emilyahmad/supercon-26/firmware/README.md

# Billboard Badge Firmware

# Micropython
Baseline micropython 1.27
Download from https://micropython.org/download/ESP32_GENERIC_S3/ `Firmware (Support for Octal-SPIRAM)` v1.27.0 .bin
`esptool.py --baud 460800 write_flash 0 ~/Downloads/ESP32_GENERIC_S3-SPIRAM_OCT-20251209-v1.27.0.bin`

# Build notes (lvgl_micropython) (Deprecated)
You need to sync the lvgl_micropython submodule and it's recursive submoules.
Then in `firmware/lvgl_micropython/lib/lv_conf.h`, find `#define LV_USE_LODEPNG 1` and change it to `0`.

lvgl_micropython build command from `firmware/lvgl_micropython`: `GEN_SCRIPT=python python make.py esp32s3 --custom-board-path=../lvgl_billboard_badge/`
Requires `toml` python package be installed.

Building outputs a command to flash: `~/.espressif/python_env/idf5.5_py3.14_env/bin/python -m esptool --chip esp32s3 -p /dev/ttyACM0 -b 460800 --before default_reset --after hard_reset write_flash --flash_mode dio --flash_size 16MB --flash_freq 80m --erase-all 0x0 ./build/lvgl_micropy_lvgl_billboard_badge.bin`

# Build notes (lv_micropython)

Install esp-idf: https://github.com/lvgl/lv_micropython/blob/master/ports/esp32/README.md#setting-up-the-toolchain-and-esp-idf
`./install.sh` and `. ./export.sh` in the shell that will be doing builds.

In `firmware/lv_micropython/ports/esp32` run `make BOARD=ESP32_GENERIC_S3 BOARD_VARIANT=BILLBOARD_BADGE`  to build and `python -m esptool --chip esp32s3 -b 460800 --before default_reset --after hard_reset write_flash --flash_mode dio --flash_size 16MB --flash_freq 80m 0x0 build-ESP32_GENERIC_S3-BILLBOARD_BADGE/bootloader/bootloader.bin 0x8000 build-ESP32_GENERIC_S3-BILLBOARD_BADGE/partition_table/partition-table.bin 0x10000 build-ESP32_GENERIC_S3-BILLBOARD_BADGE/micropython.bin` to flash.
You will need to `make clean BOARD=ESP32_GENERIC_S3 BOARD_VARIANT=BILLBOARD_BADGE` (yes including the arguments) to rebuild. The BOARD argument defines a build directory, so clean won't clean the correct directory without it.

Flashing the pre-built bin files: From `firmware/` run `python -m esptool --chip esp32s3 -b 460800 --before default_reset --after hard_reset write_flash --flash_mode dio --flash_size 8MB --flash_freq 80m 0x0 bin/bootloader.bin 0x8000 bin/partition-table.bin 0x10000 bin/micropython.bin`. To get into the mode to flash this, you need to hold down the BOOT button while either plugging in or pressing and releasing RESET.

## lv_micropython changes:
Copy the files from `firmware/lv_files/` to their matching paths, ex: `lv_files/foo/` -> `lv_micropython/foo/`.
