emilyahmad/supercon-26/assets/gallery/2026recap-dithered.png

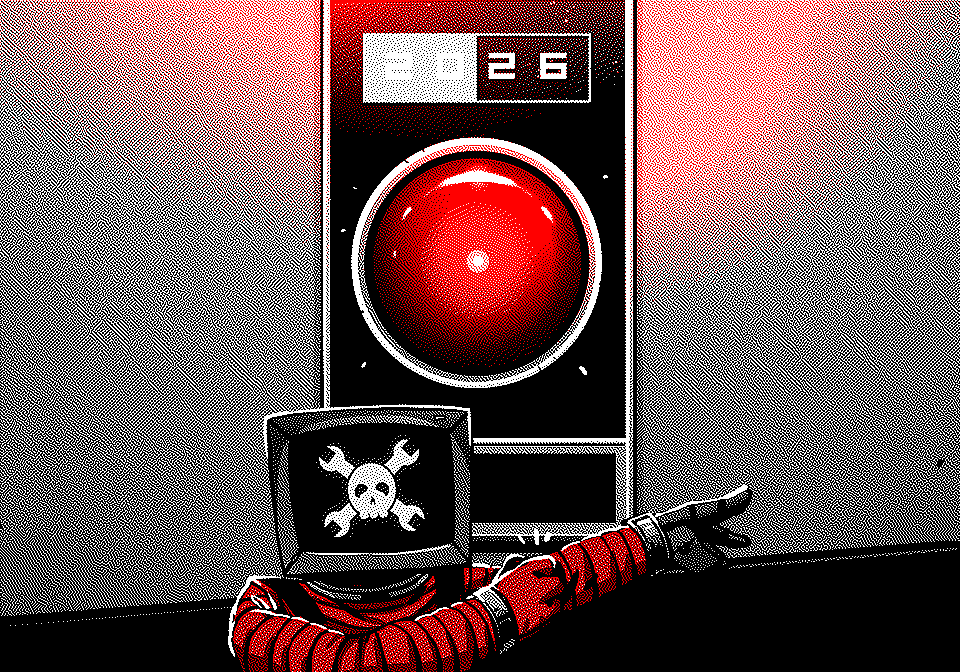
assets/gallery/2026recap-dithered.png
