emilyahmad/supercon-26/assets/gallery/Accelerometers-dithered.png

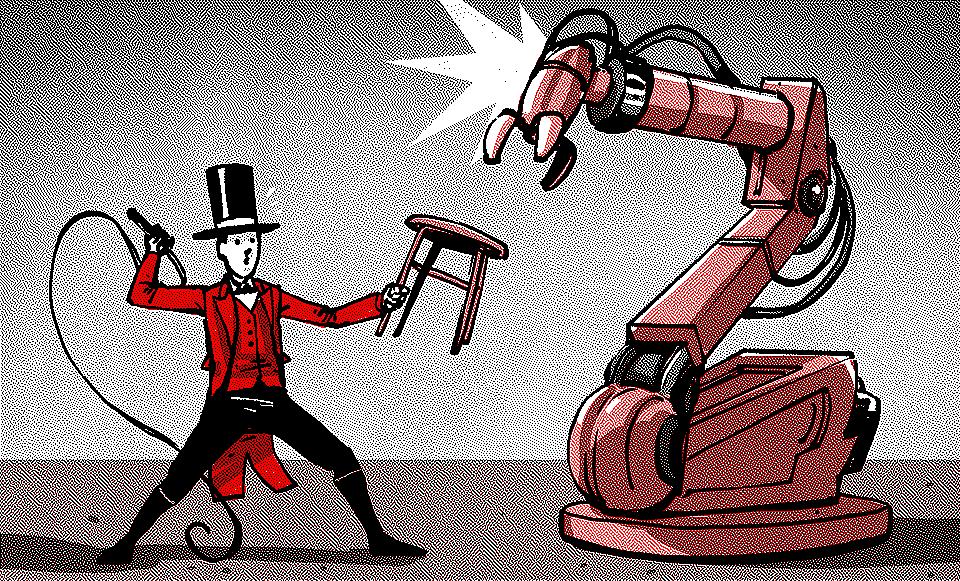
assets/gallery/Accelerometers-dithered.png
