emilyahmad/supercon-26/assets/gallery/AmateurRadio-dithered_dizzy_bw.png

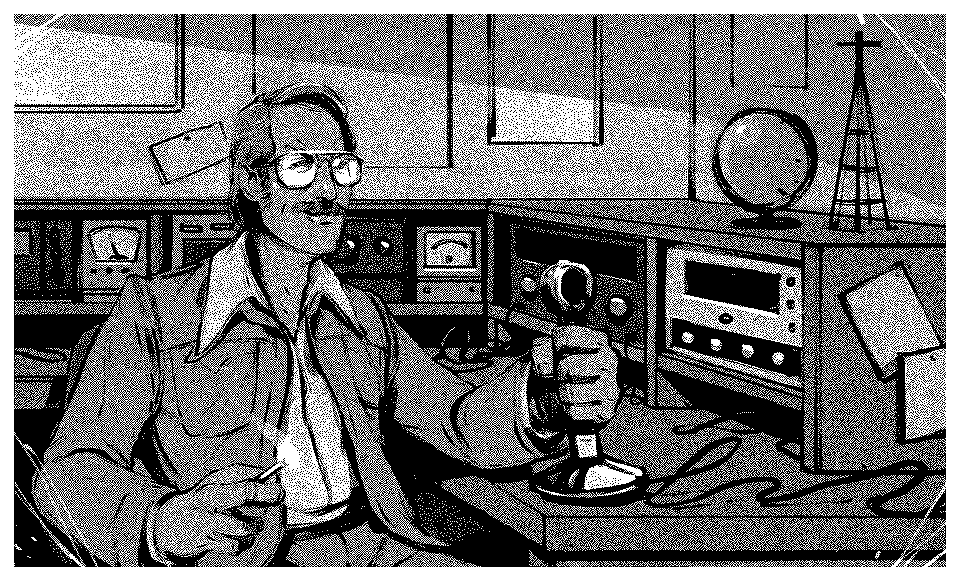
assets/gallery/AmateurRadio-dithered_dizzy_bw.png
