emilyahmad/supercon-26/assets/gallery/COBOL-dithered.png

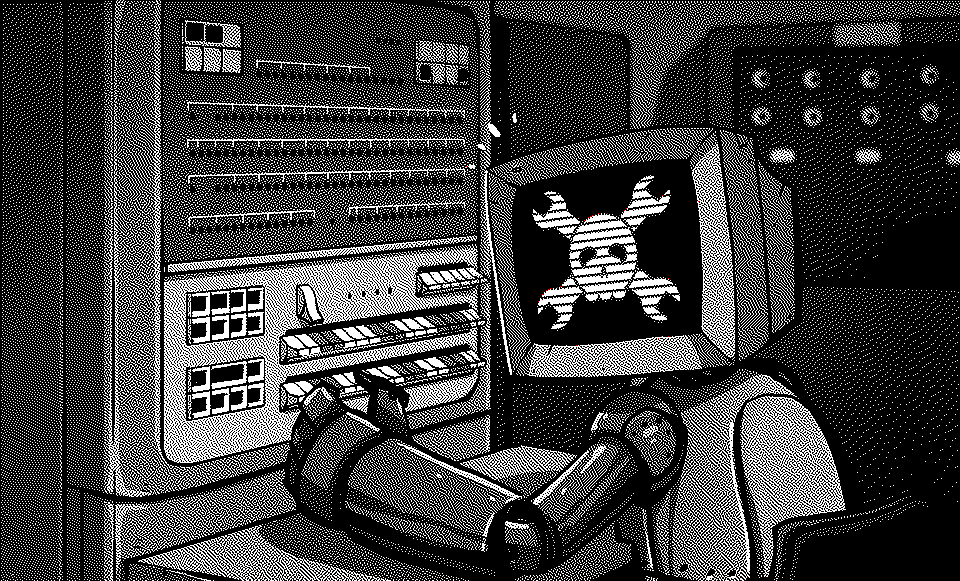
assets/gallery/COBOL-dithered.png
