emilyahmad/supercon-26/assets/gallery/Glass-dithered.png

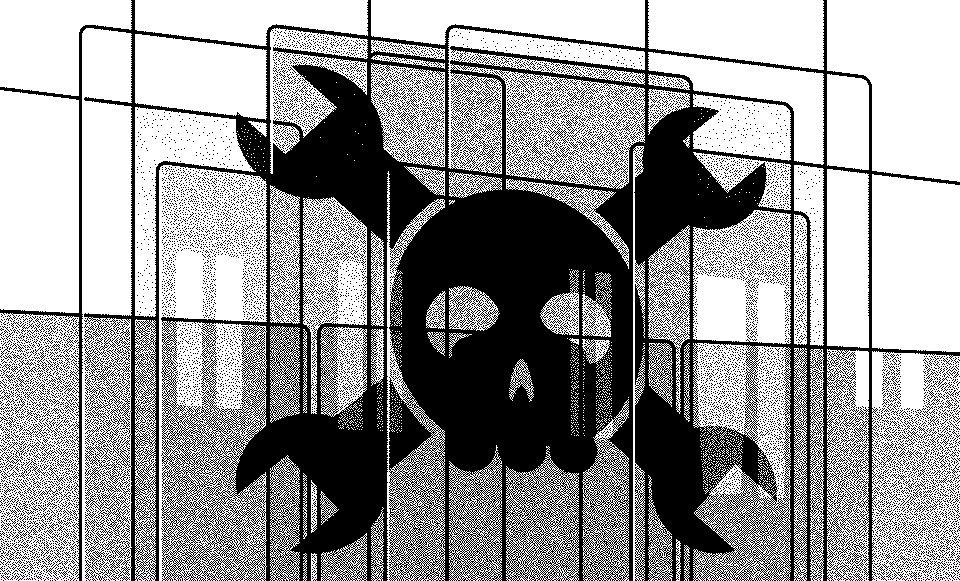
assets/gallery/Glass-dithered.png
