emilyahmad/supercon-26/assets/gallery/Hackaday20-dithered.png

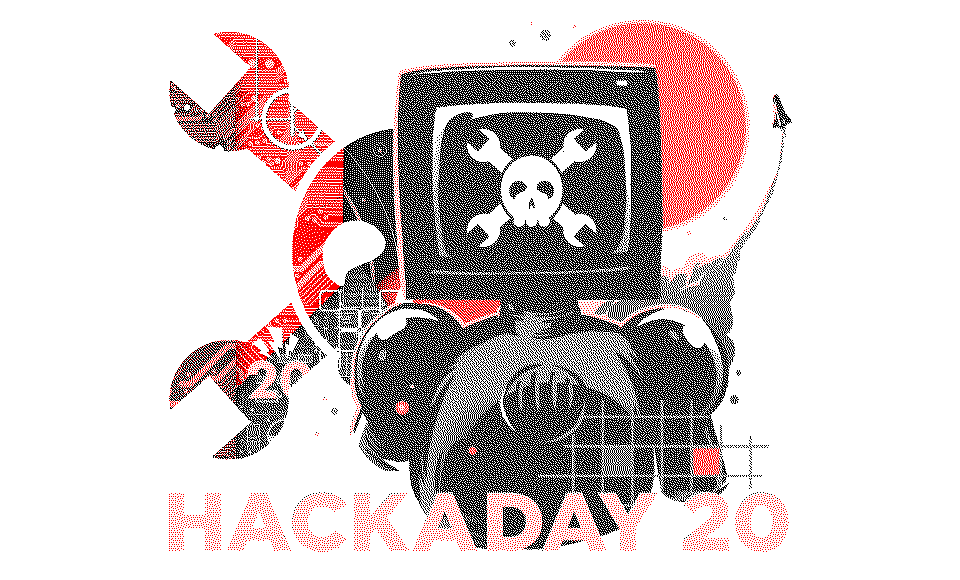
assets/gallery/Hackaday20-dithered.png
