emilyahmad/supercon-26/assets/gallery/had_01_black.jpg

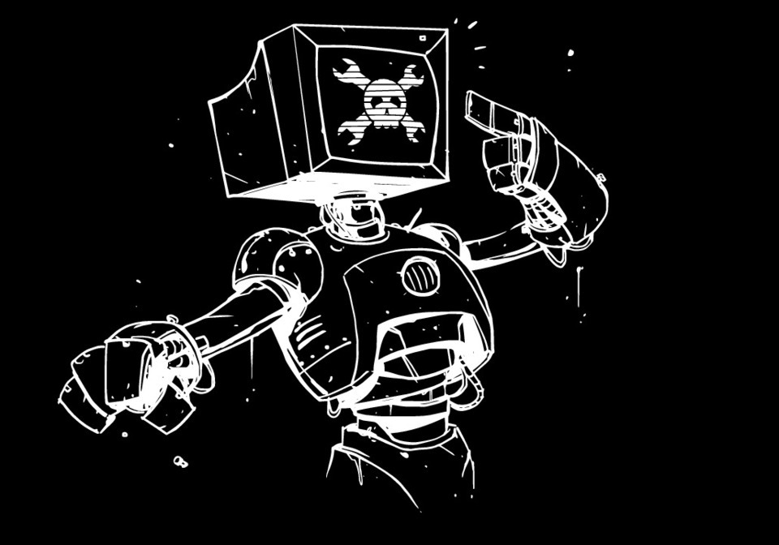
assets/gallery/had_01_black.jpg
