emilyahmad/supercon-26/assets/gallery/HomeElectrical-dithered.png

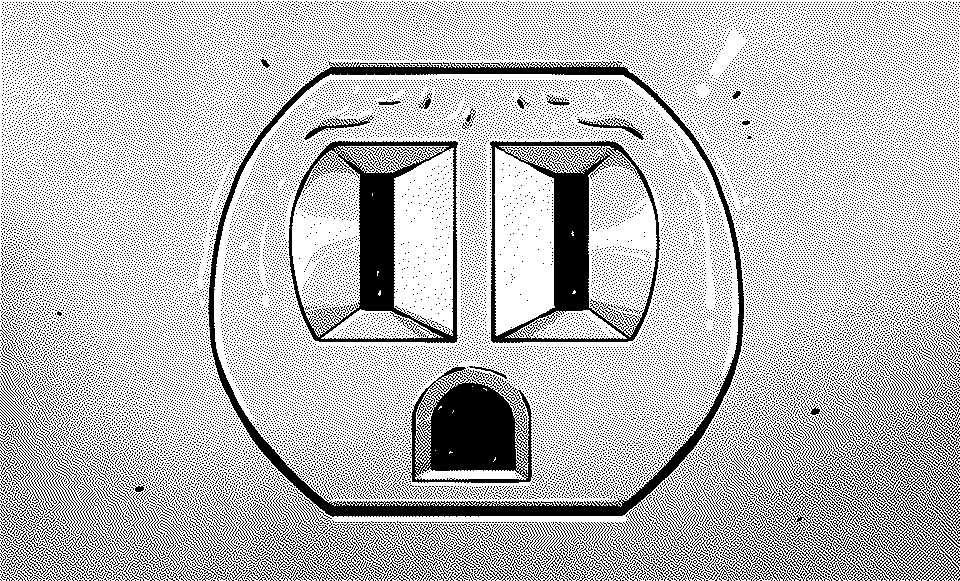
assets/gallery/HomeElectrical-dithered.png
