emilyahmad/supercon-26/assets/gallery/IntelManagment-dithered.png

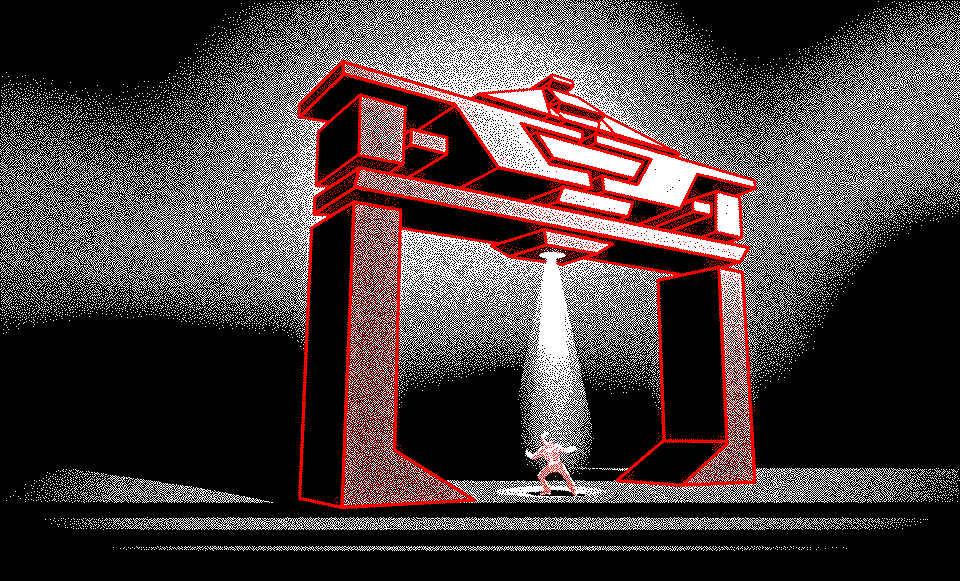
assets/gallery/IntelManagment-dithered.png
