emilyahmad/supercon-26/assets/gallery/LED-dithered.png

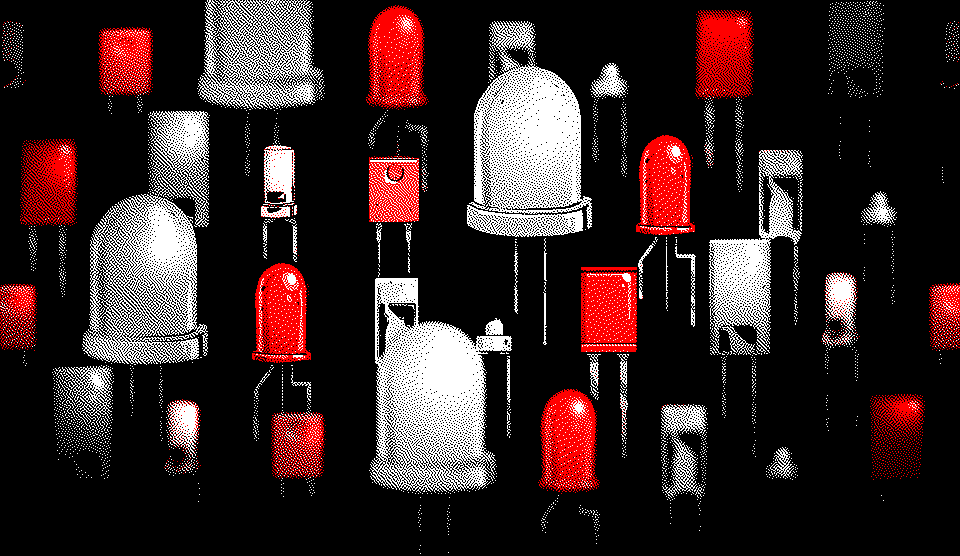
assets/gallery/LED-dithered.png
