emilyahmad/supercon-26/assets/gallery/LEDsensor-dithered.png

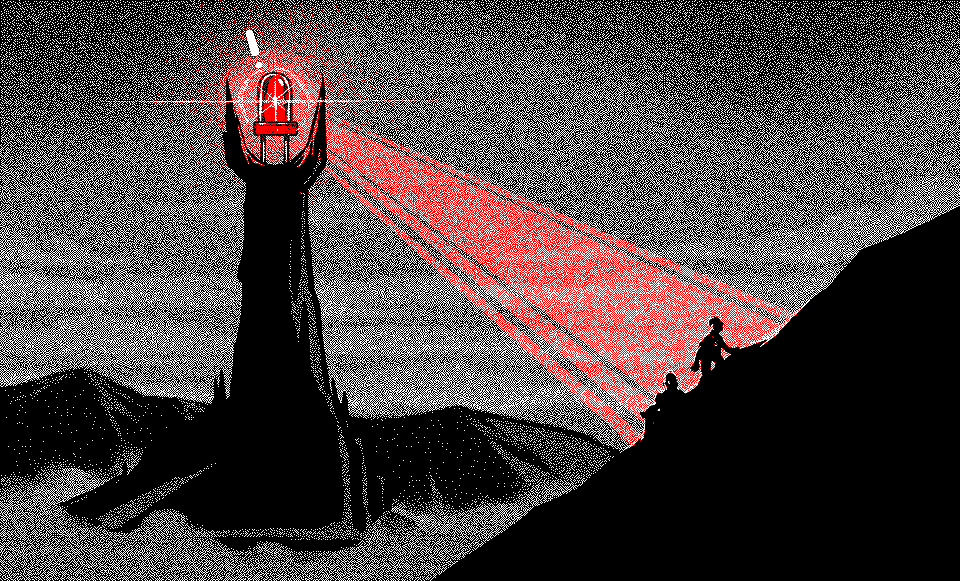
assets/gallery/LEDsensor-dithered.png
