emilyahmad/supercon-26/assets/gallery/London-dithered.png

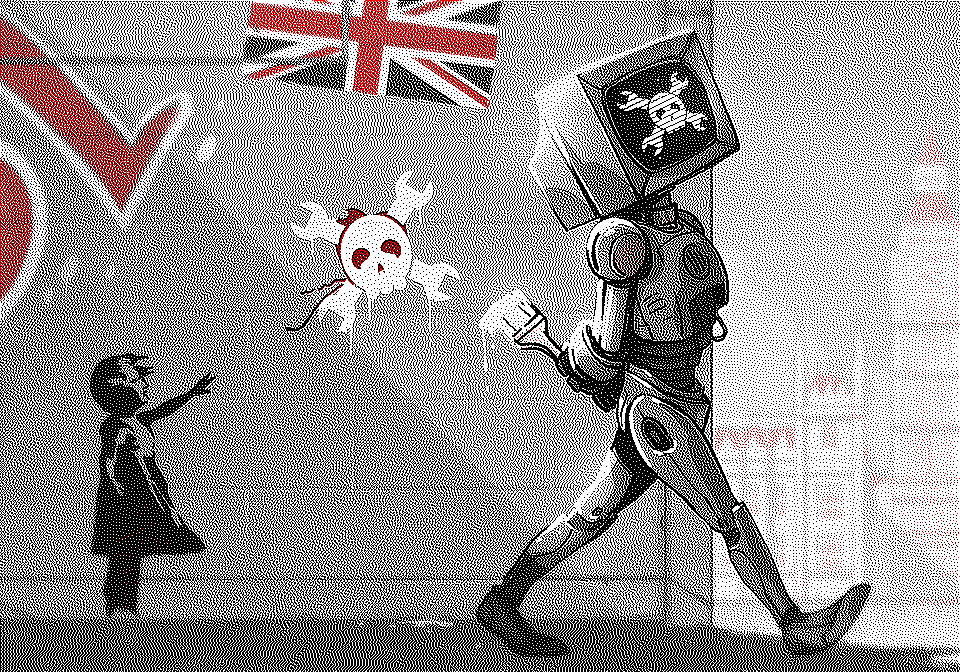
assets/gallery/London-dithered.png
