emilyahmad/supercon-26/assets/gallery/Mars-dithered.png

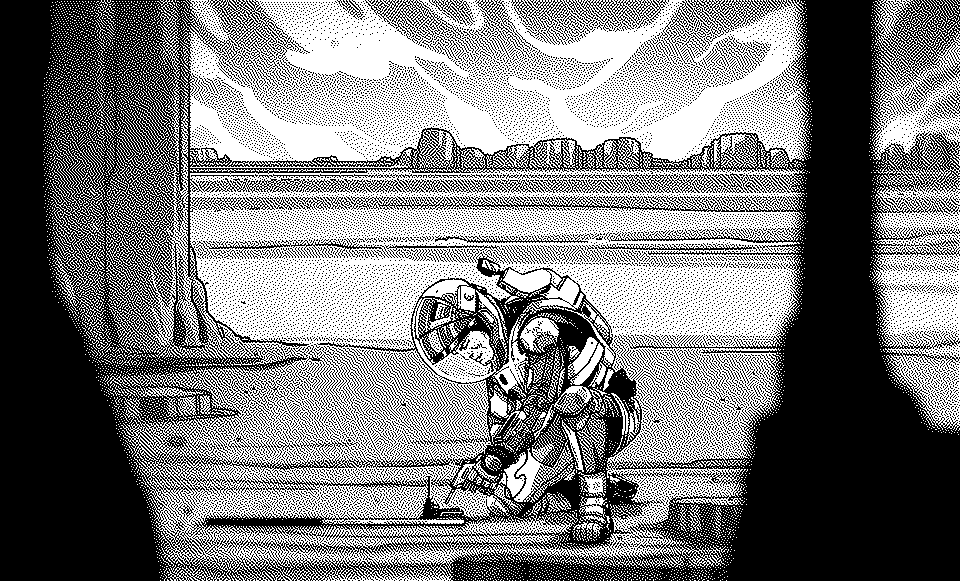
assets/gallery/Mars-dithered.png
