emilyahmad/supercon-26/assets/gallery/Memories-dithered.png

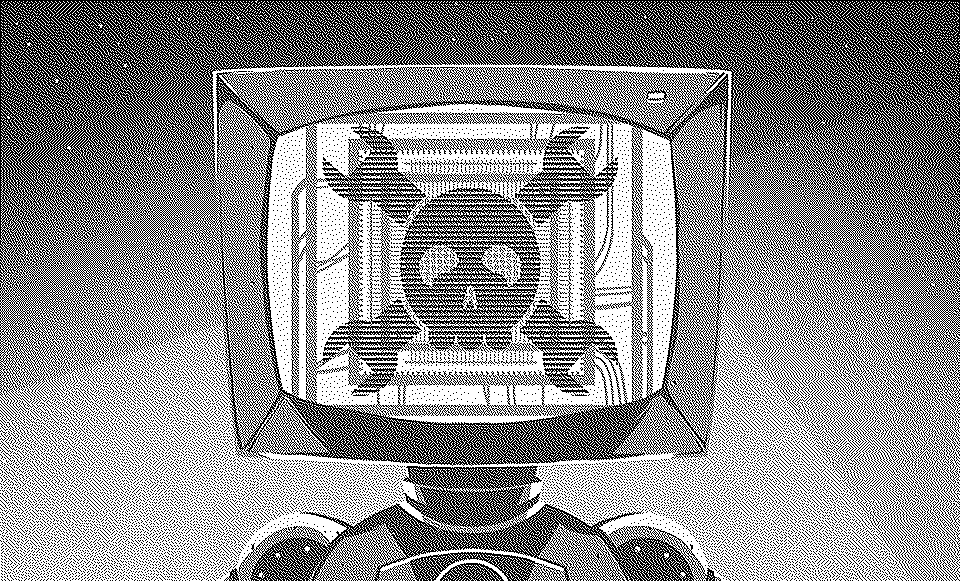
assets/gallery/Memories-dithered.png
