emilyahmad/supercon-26/assets/gallery/MisuingDIP-dithered.png

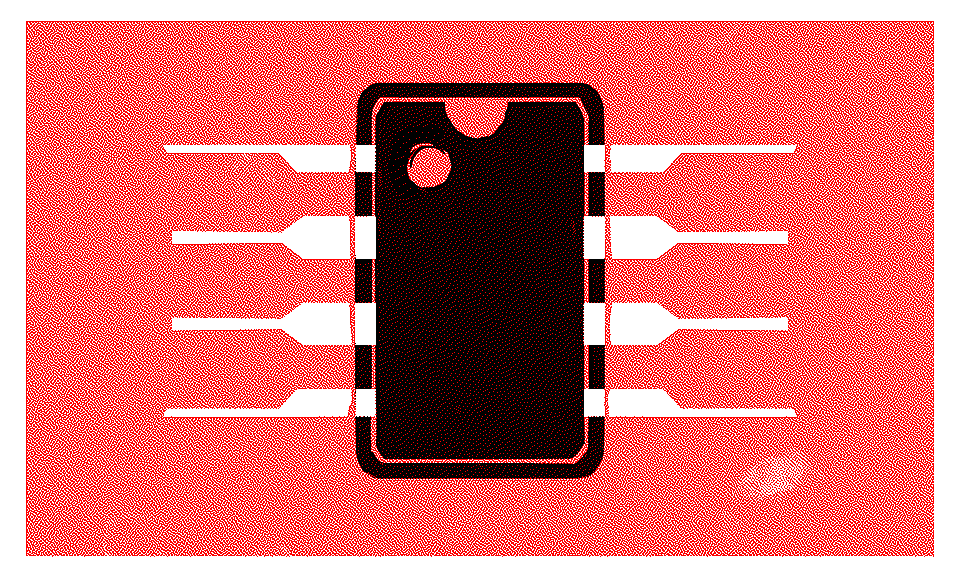
assets/gallery/MisuingDIP-dithered.png
