emilyahmad/supercon-26/assets/gallery/PCBdesign-dithered-shiaufan2.png

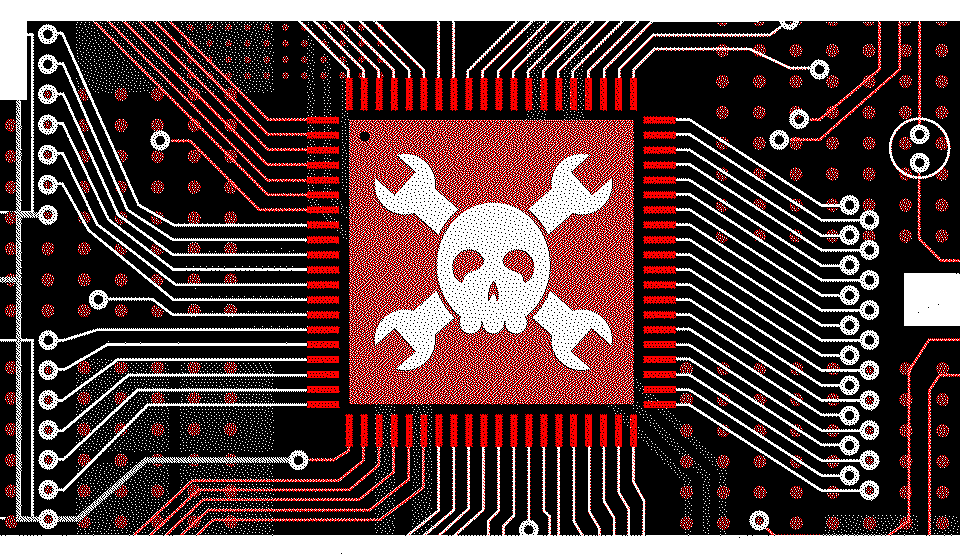
assets/gallery/PCBdesign-dithered-shiaufan2.png
