emilyahmad/supercon-26/assets/gallery/Pioneer-dithered.png

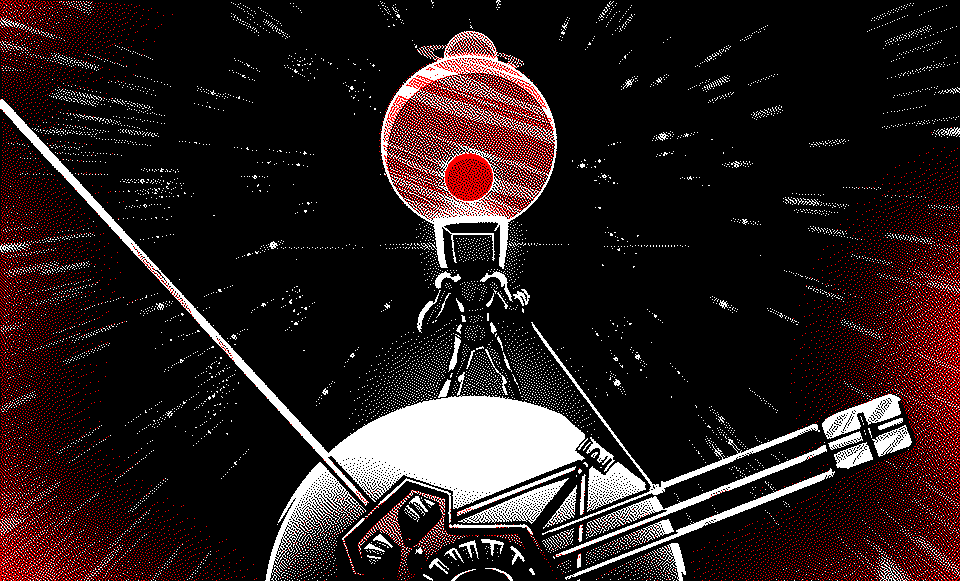
assets/gallery/Pioneer-dithered.png
