emilyahmad/supercon-26/assets/gallery/Potentiometer-dithered.png

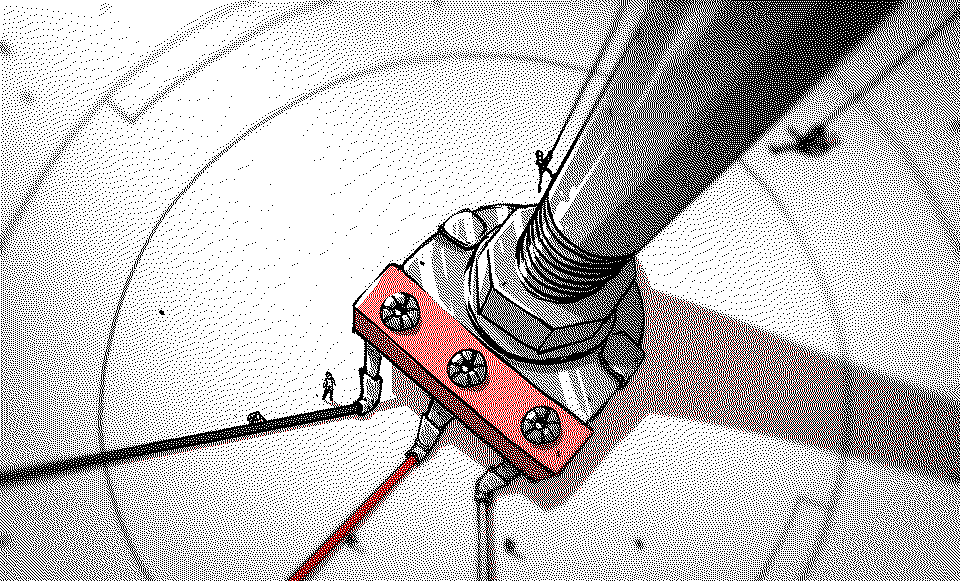
assets/gallery/Potentiometer-dithered.png
