emilyahmad/supercon-26/assets/gallery/RockerBogie-dithered.png

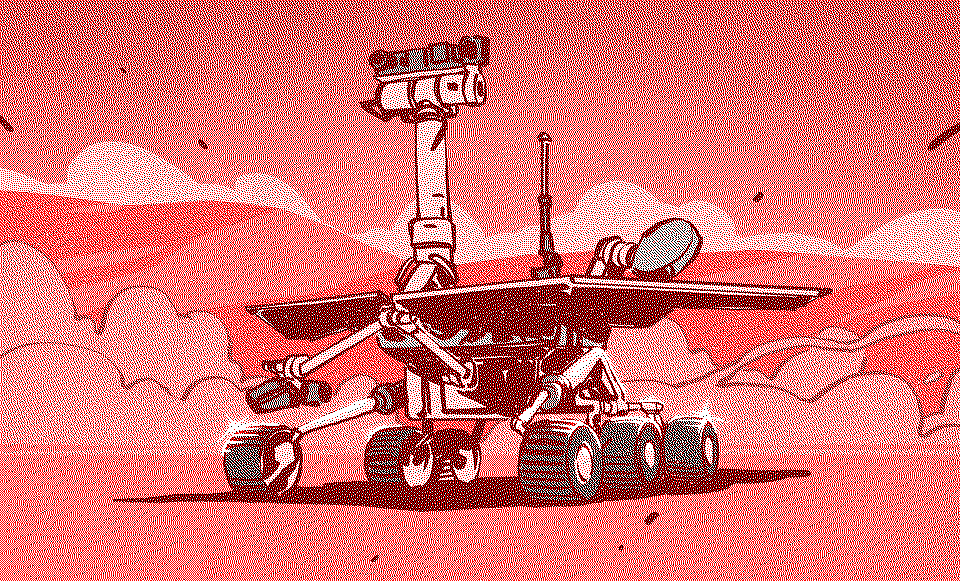
assets/gallery/RockerBogie-dithered.png
