emilyahmad/supercon-26/assets/gallery/RPN-dithered_atkinson.png

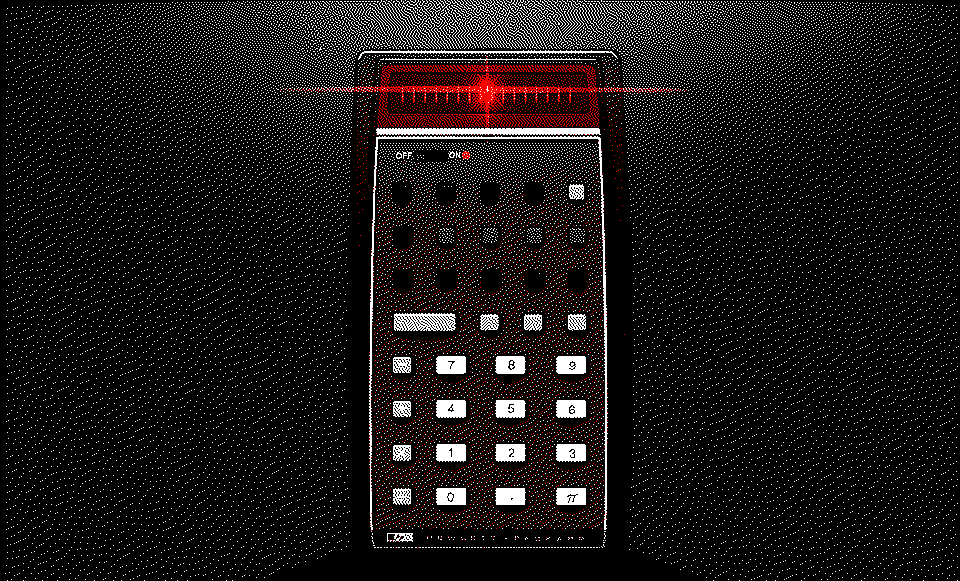
assets/gallery/RPN-dithered_atkinson.png
