emilyahmad/supercon-26/assets/gallery/Scrappy-dithered.png

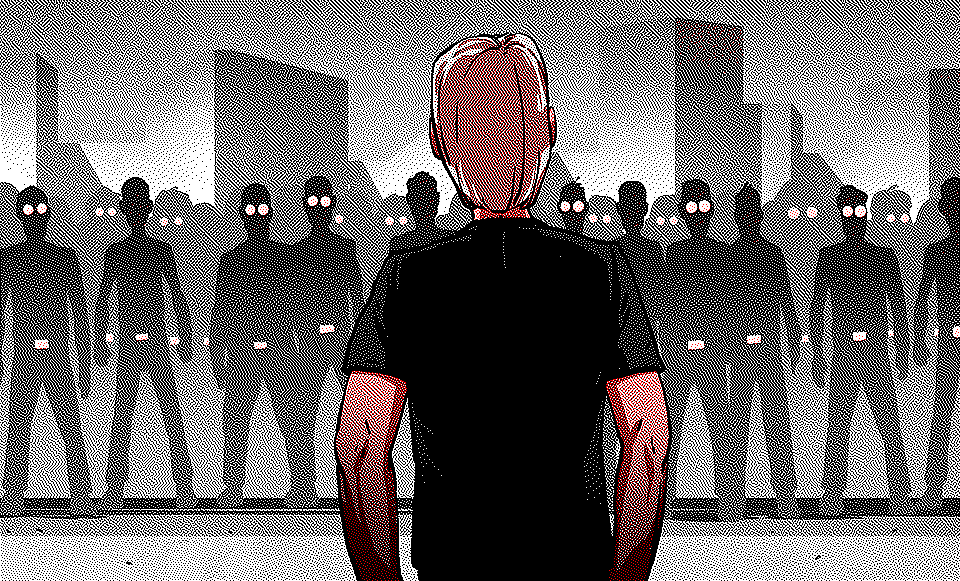
assets/gallery/Scrappy-dithered.png
