emilyahmad/supercon-26/assets/gallery/Screw-dithered.png

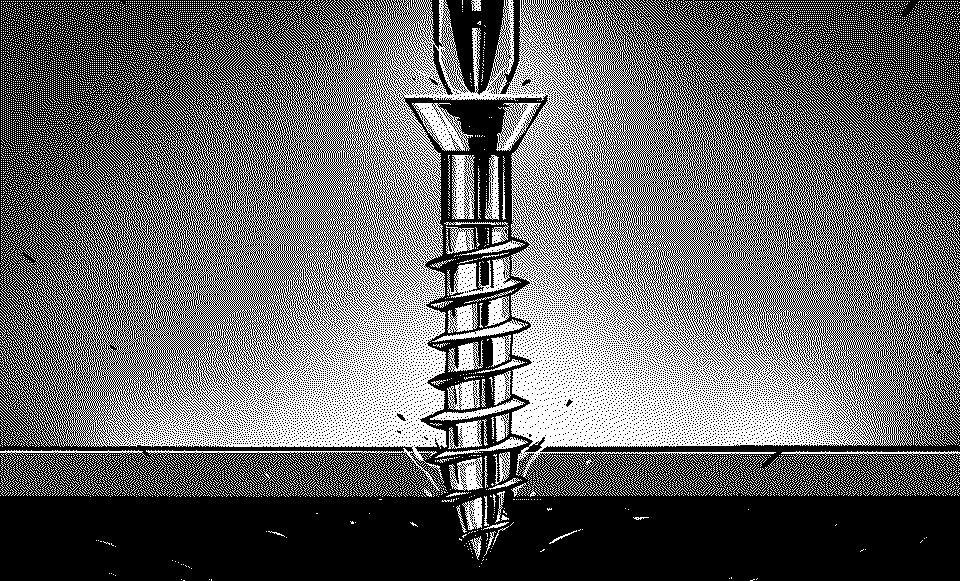
assets/gallery/Screw-dithered.png
