emilyahmad/supercon-26/assets/gallery/Security-dithered.png

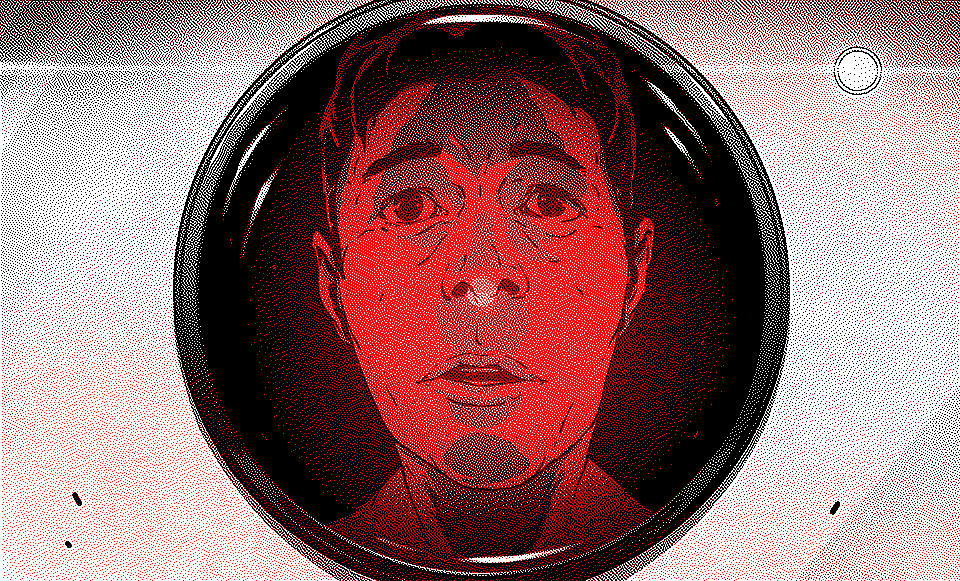
assets/gallery/Security-dithered.png
