emilyahmad/supercon-26/assets/gallery/Supercon_Board_01.jpg

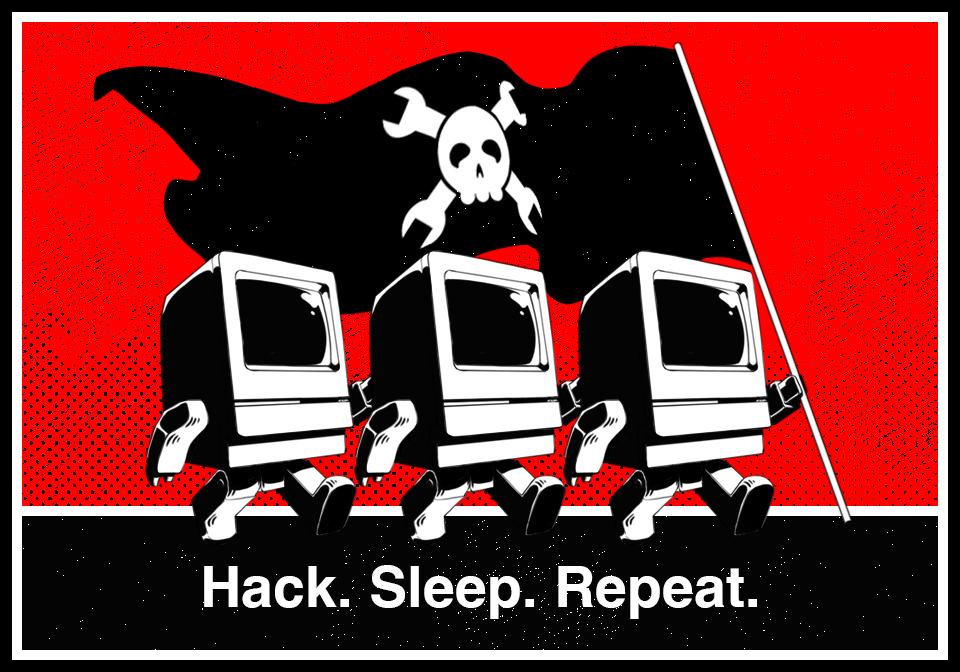
assets/gallery/Supercon_Board_01.jpg
