emilyahmad/supercon-26/assets/gallery/Supercon_Board_02.jpg

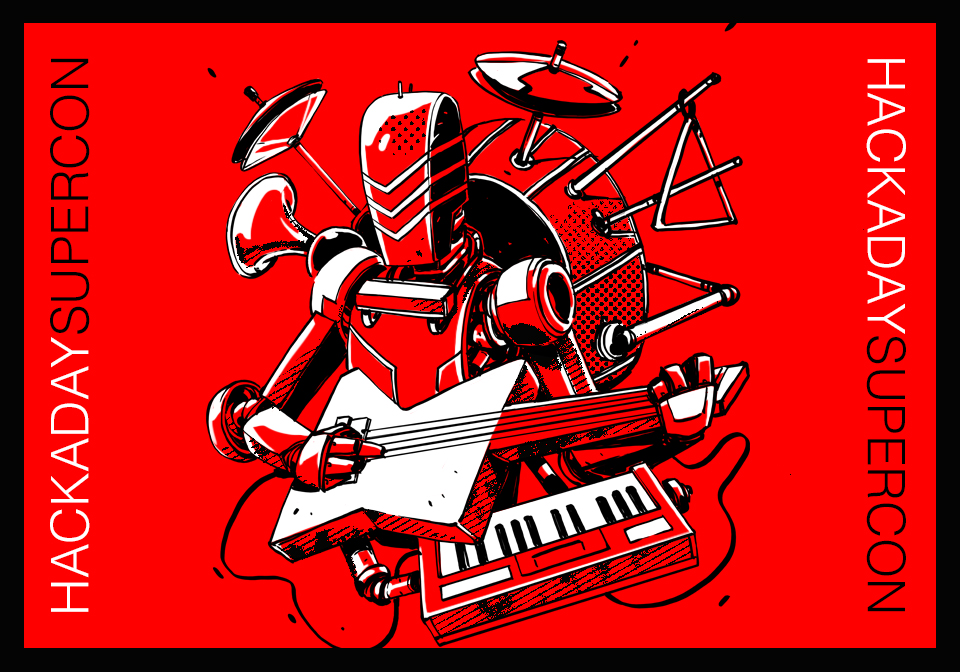
assets/gallery/Supercon_Board_02.jpg
