emilyahmad/supercon-26/assets/gallery/Supercon_Board_03.png

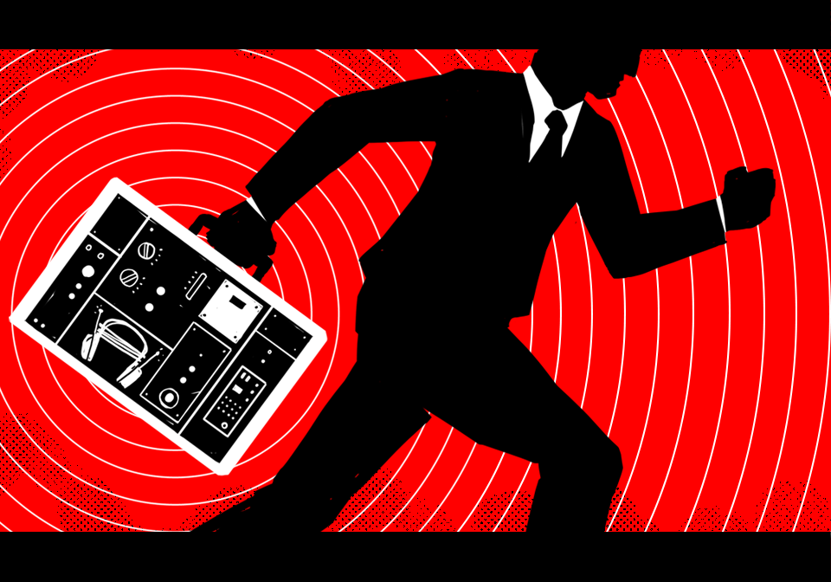
assets/gallery/Supercon_Board_03.png
