emilyahmad/supercon-26/assets/gallery/Supercon_Board_04.png

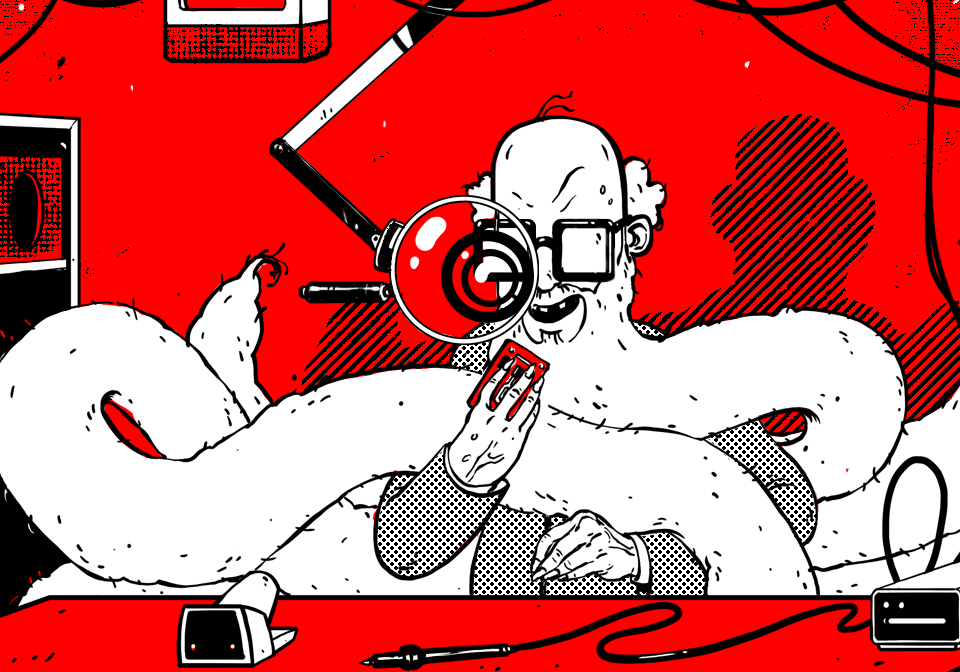
assets/gallery/Supercon_Board_04.png
