emilyahmad/supercon-26/assets/gallery/Supercon_Board_05.png

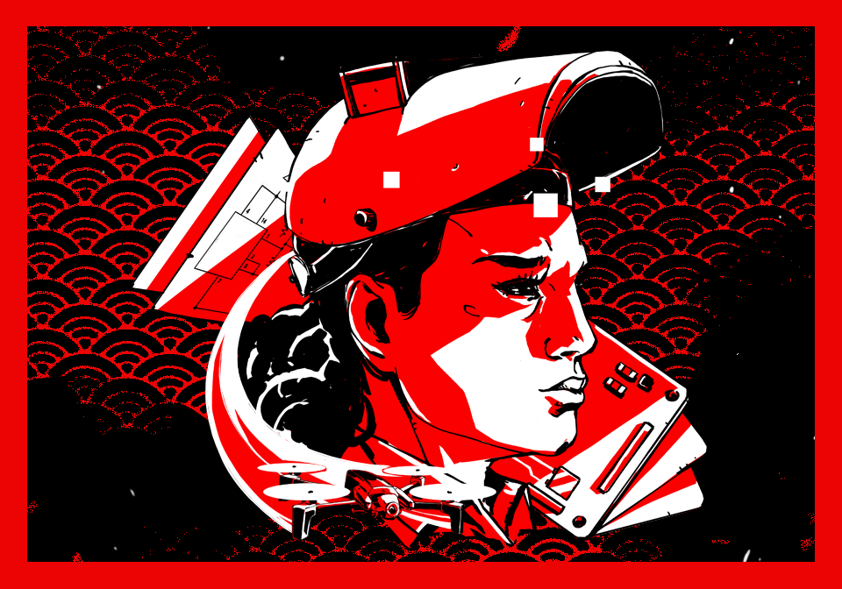
assets/gallery/Supercon_Board_05.png
