emilyahmad/supercon-26/assets/gallery/Supercon_Board_06.png

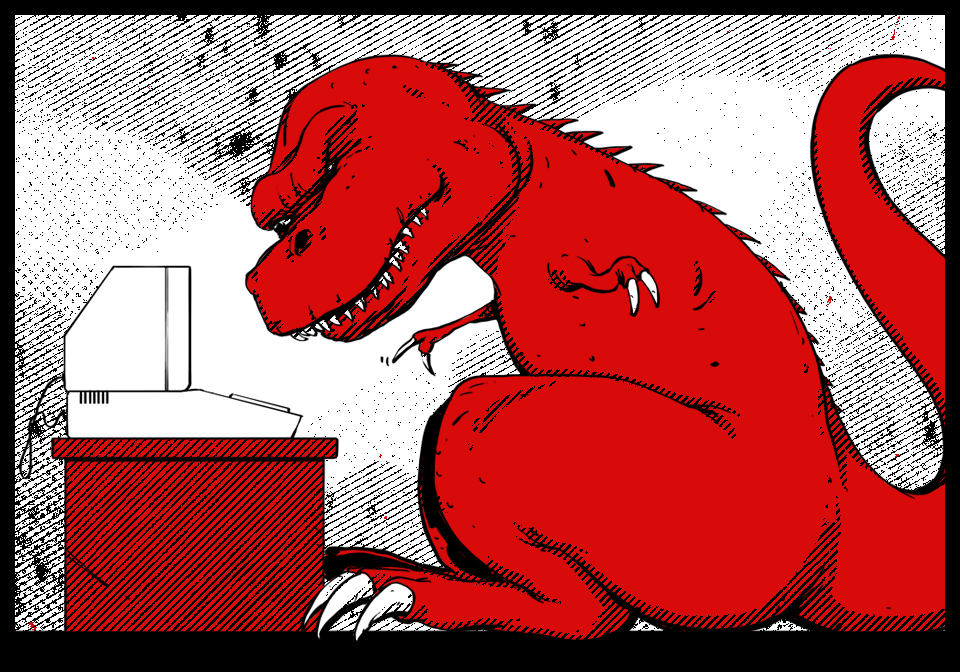
assets/gallery/Supercon_Board_06.png
