emilyahmad/supercon-26/assets/gallery/Supercon_Board_07.png

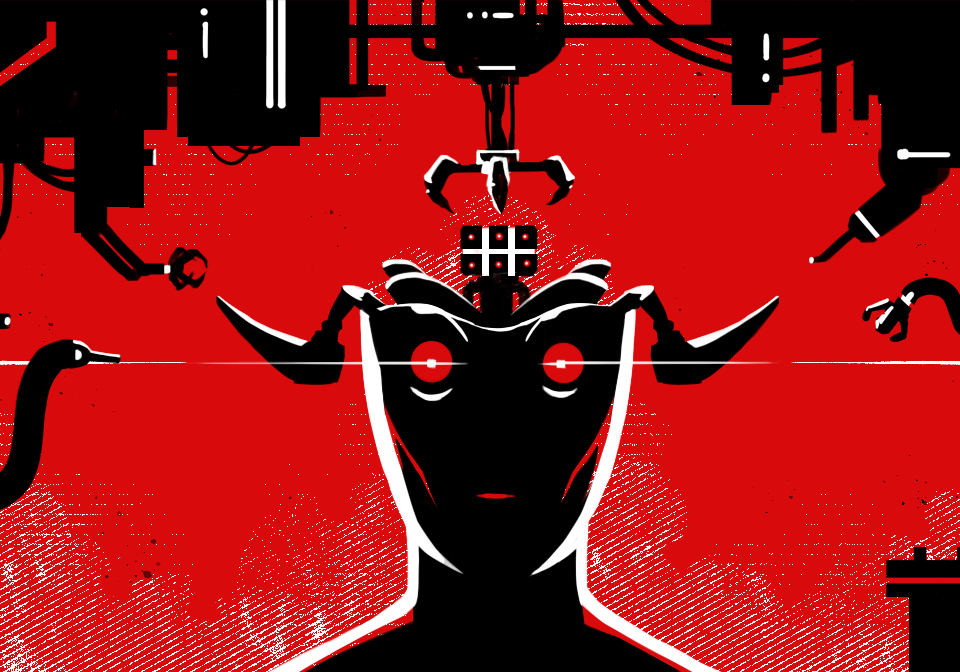
assets/gallery/Supercon_Board_07.png
