emilyahmad/supercon-26/assets/gallery/Supercon_Board_08.png

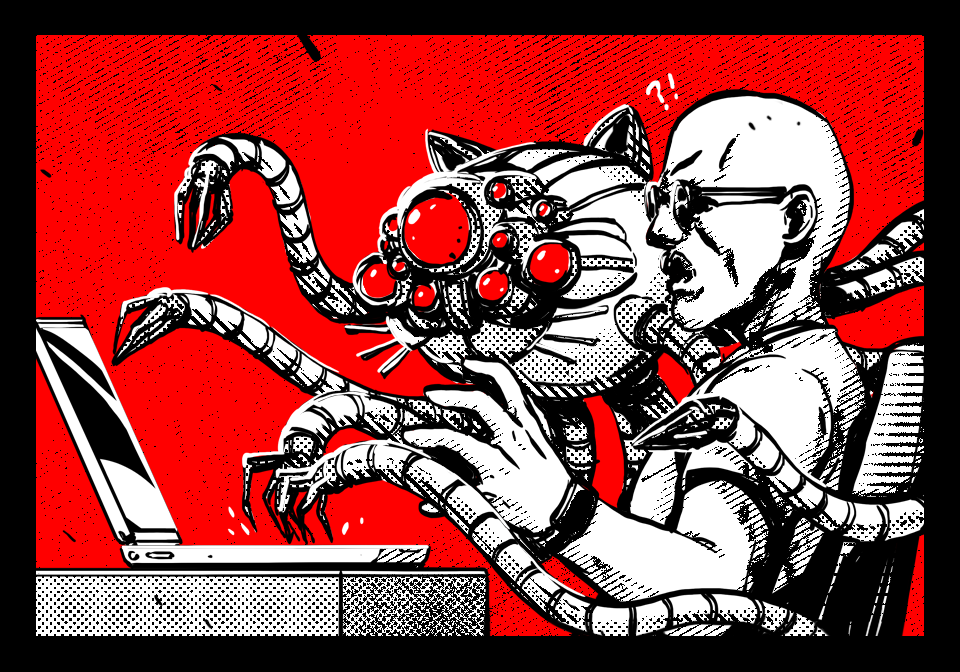
assets/gallery/Supercon_Board_08.png
