emilyahmad/supercon-26/assets/gallery/Supercon_Board_09.png

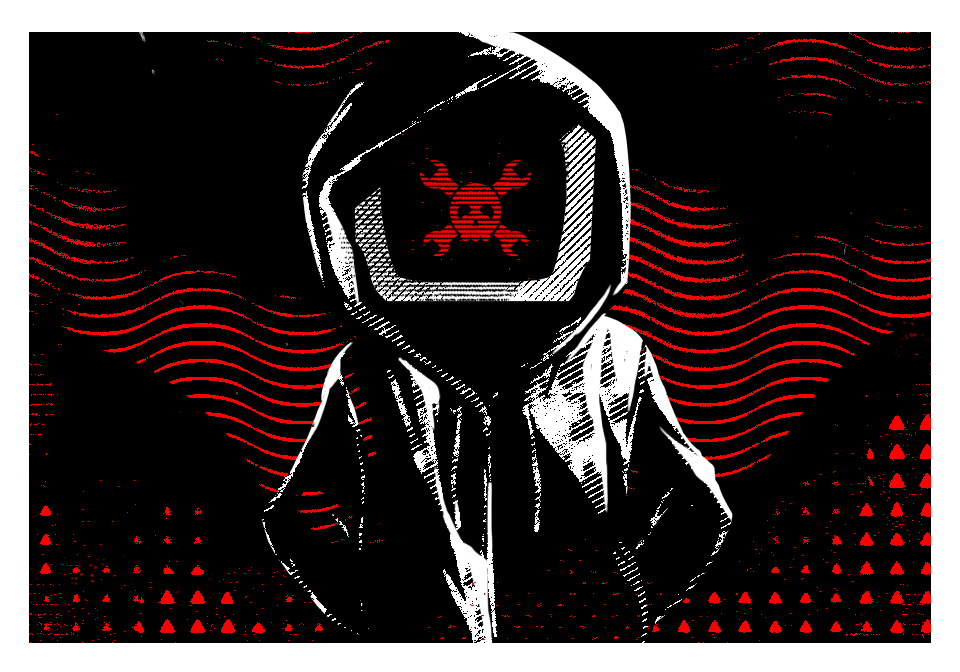
assets/gallery/Supercon_Board_09.png
