emilyahmad/supercon-26/assets/gallery/Supercon_Board_10.png

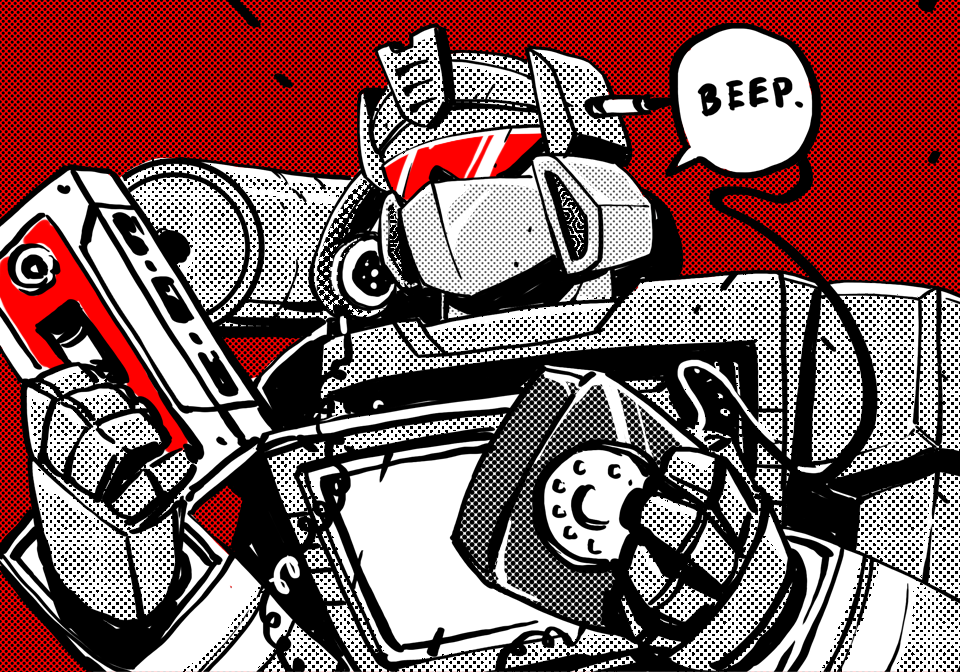
assets/gallery/Supercon_Board_10.png
