emilyahmad/supercon-26/assets/gallery/Supercon_Board_11.png

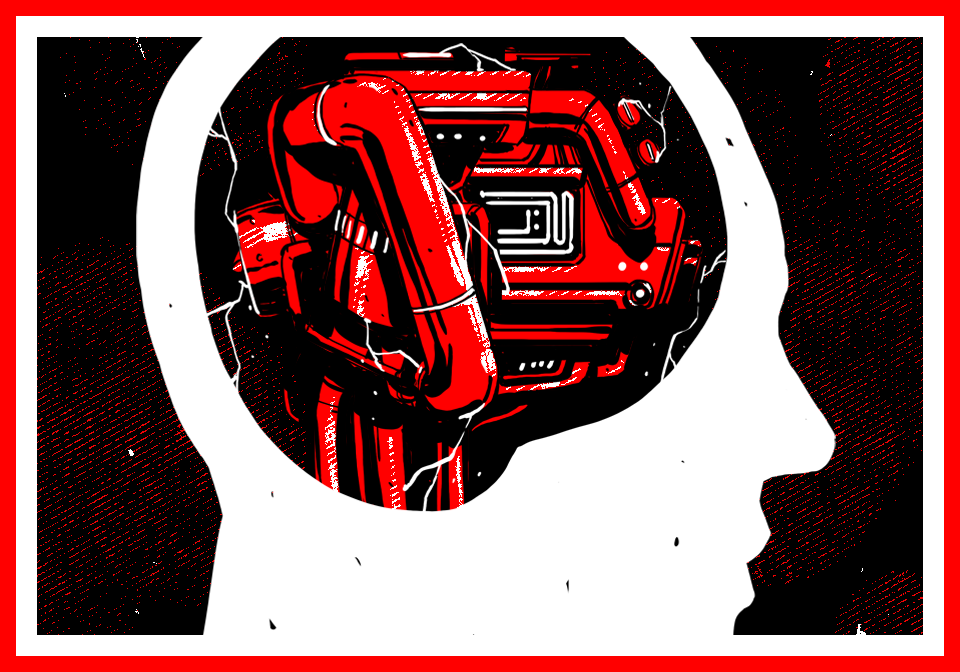
assets/gallery/Supercon_Board_11.png
