emilyahmad/supercon-26/assets/gallery/Supercon_Board_12.png

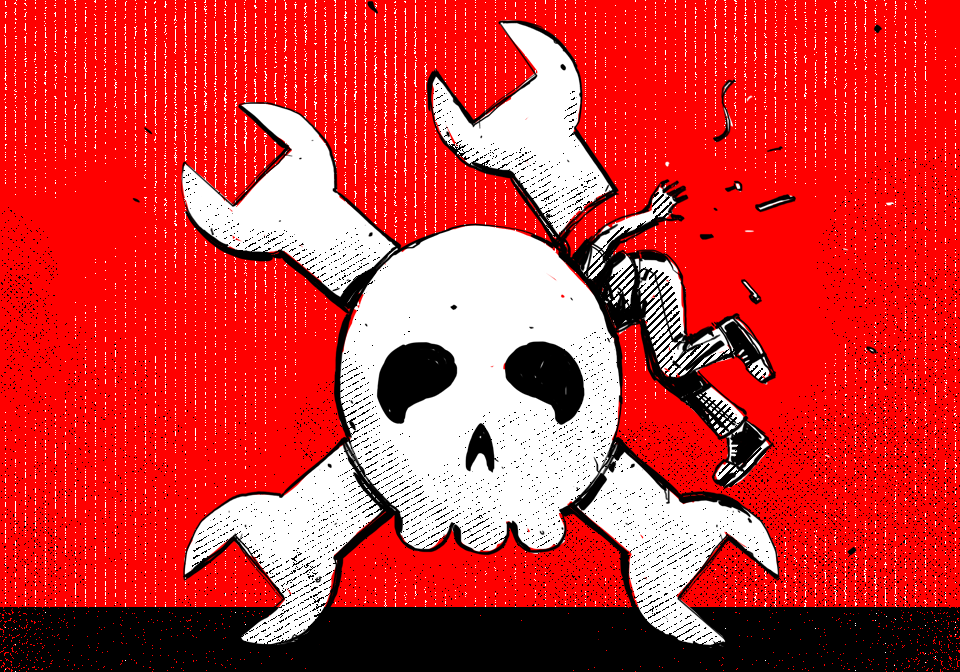
assets/gallery/Supercon_Board_12.png
