emilyahmad/supercon-26/assets/gallery/Supercon_Board_13.png

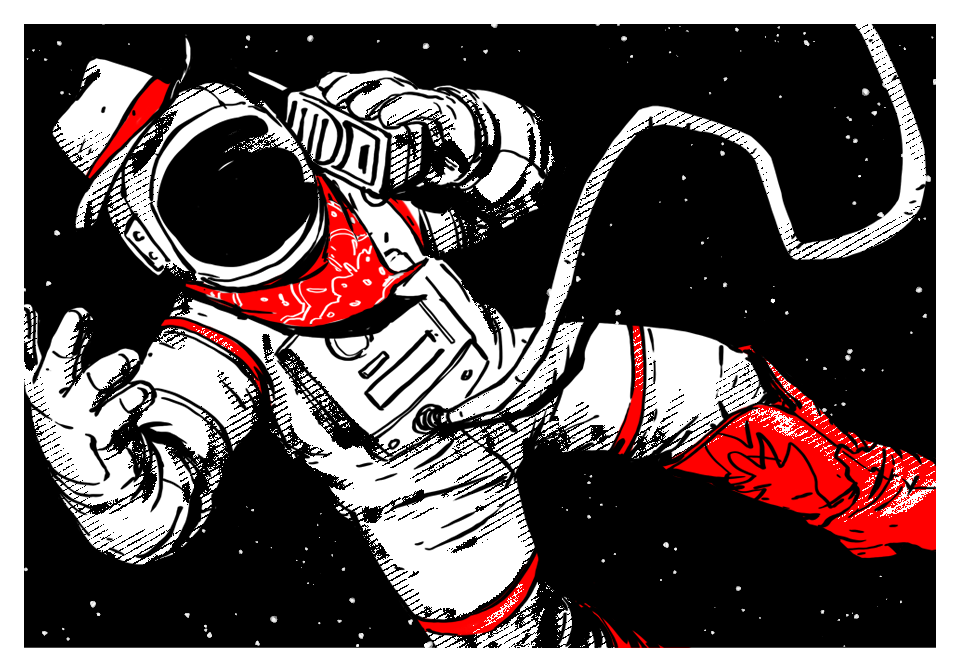
assets/gallery/Supercon_Board_13.png
