emilyahmad/supercon-26/assets/gallery/Supercon_Board_14.png

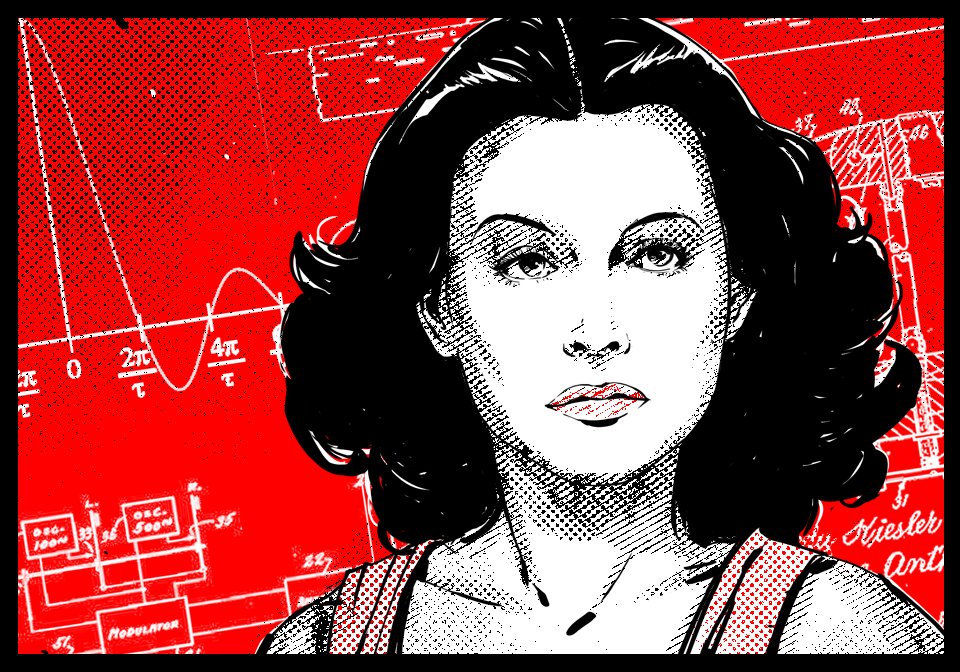
assets/gallery/Supercon_Board_14.png
