emilyahmad/supercon-26/assets/gallery/Supercon_Board_15.png

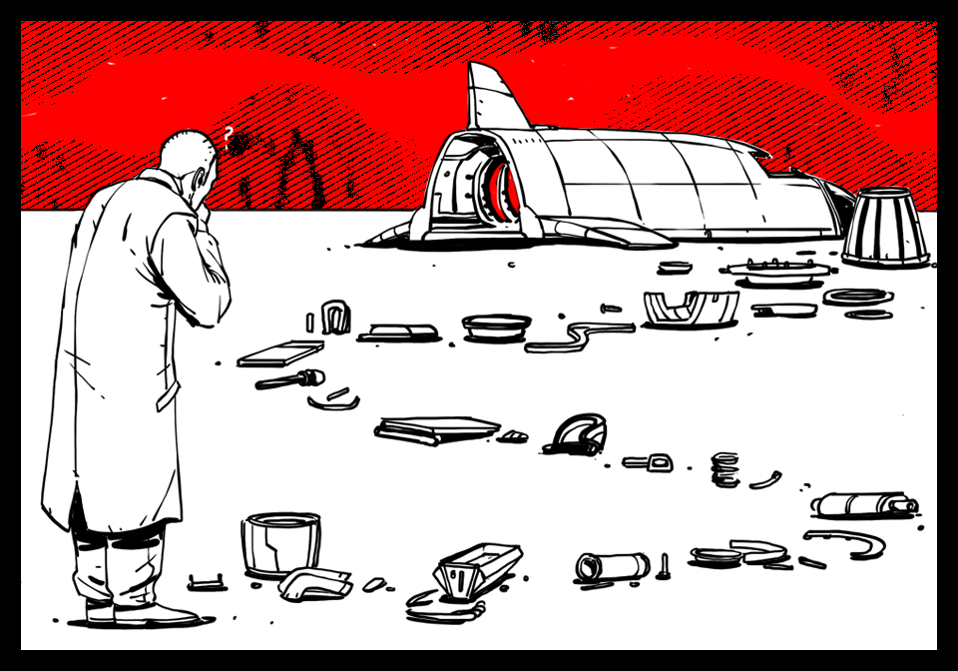
assets/gallery/Supercon_Board_15.png
