emilyahmad/supercon-26/assets/gallery/Supercon_Board_16.png

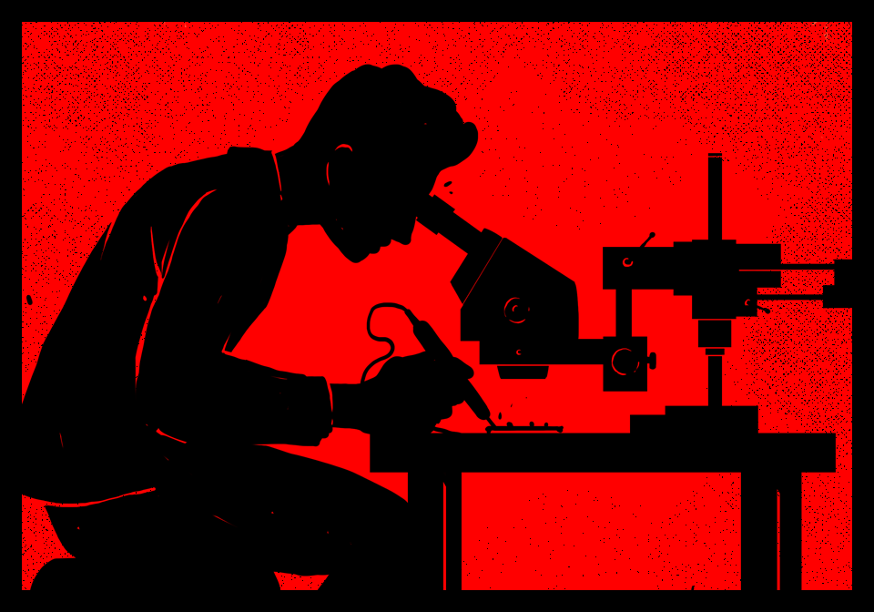
assets/gallery/Supercon_Board_16.png
