emilyahmad/supercon-26/assets/gallery/Supercon_Board_17.png

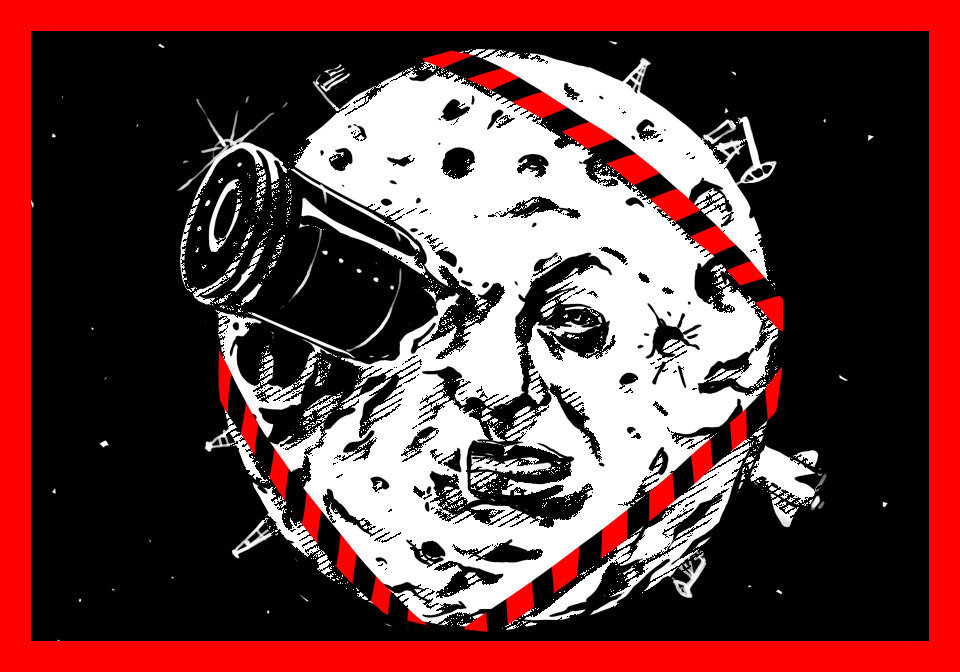
assets/gallery/Supercon_Board_17.png
