emilyahmad/supercon-26/assets/gallery/Supercon_Board_18.png

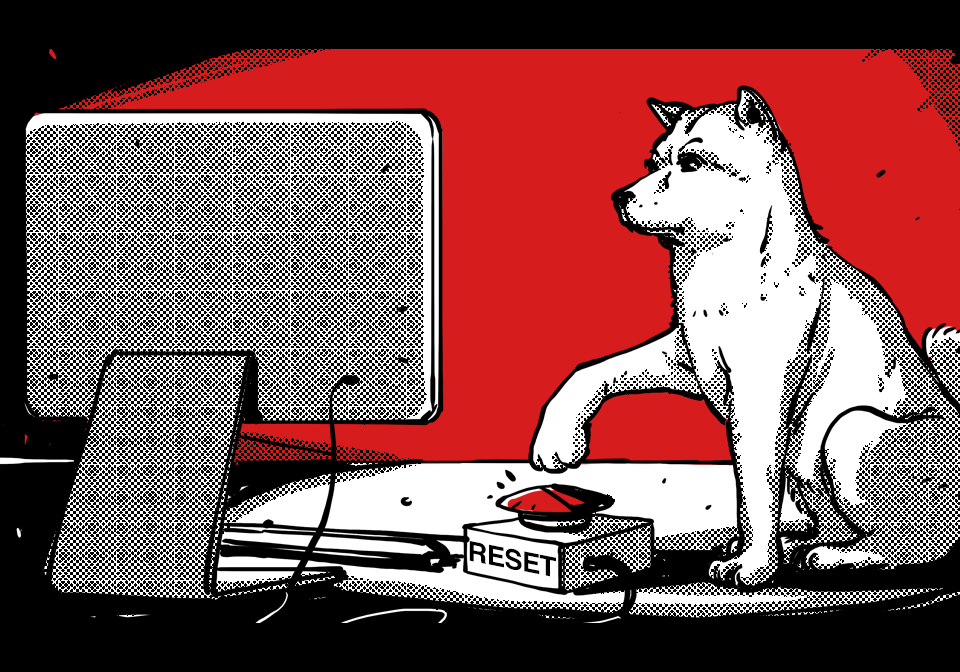
assets/gallery/Supercon_Board_18.png
