emilyahmad/supercon-26/assets/gallery/Supercon_Board_19.png

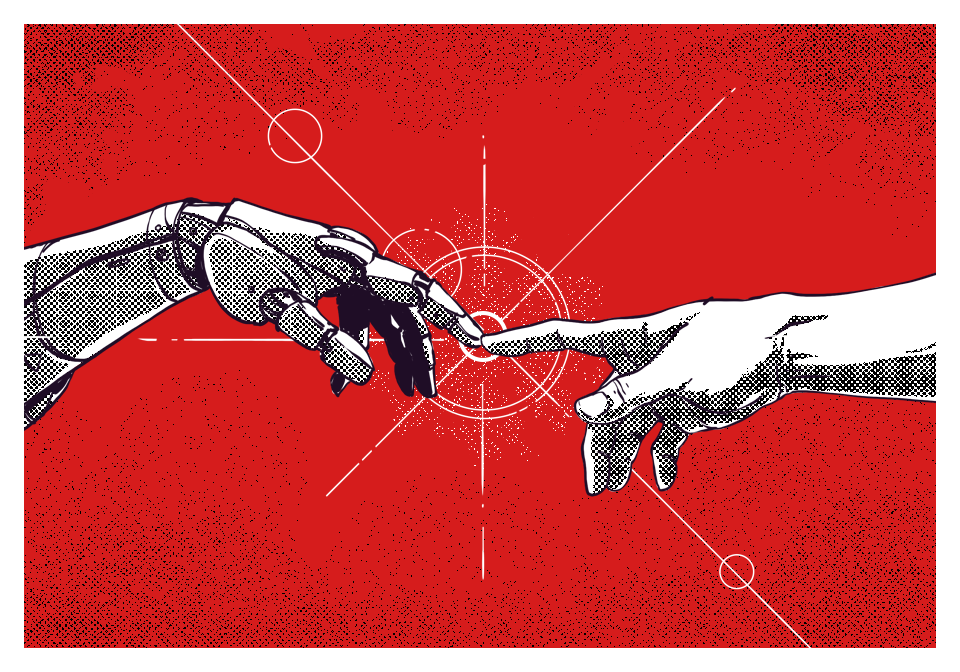
assets/gallery/Supercon_Board_19.png
