emilyahmad/supercon-26/assets/gallery/Supercon_Board_20.png

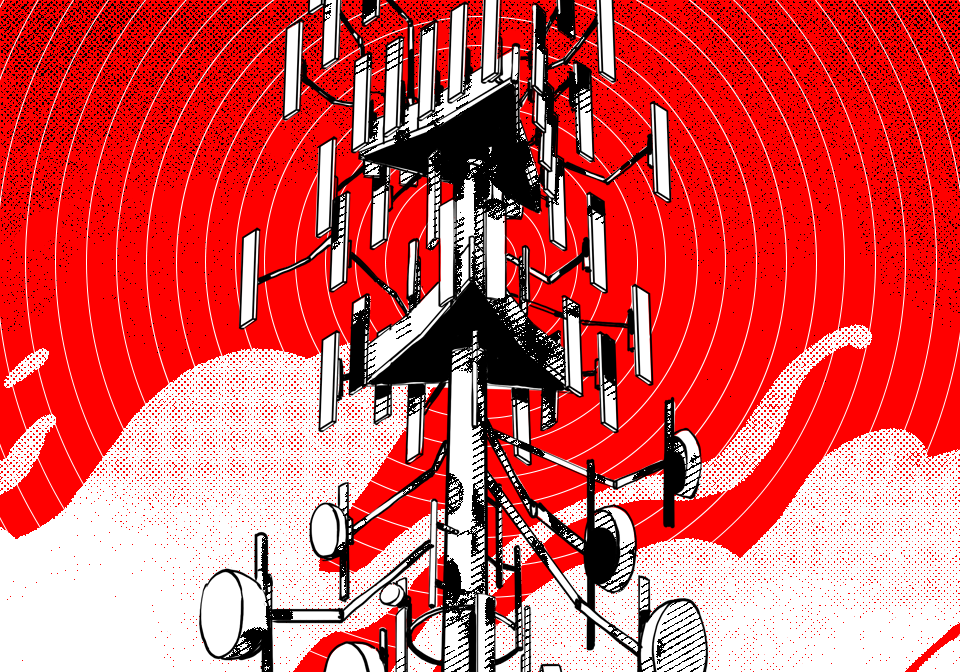
assets/gallery/Supercon_Board_20.png
