emilyahmad/supercon-26/assets/gallery/Teleportation-dithered.png

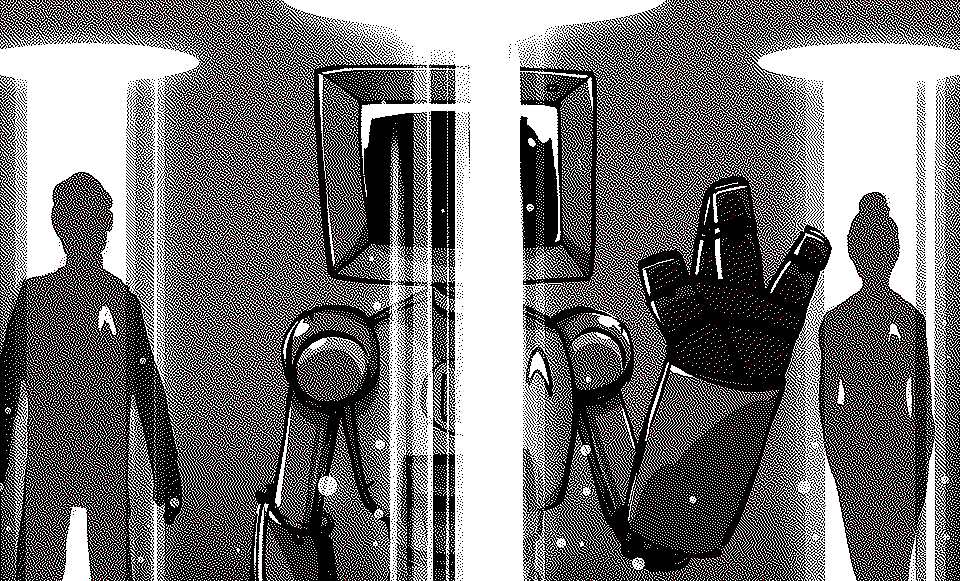
assets/gallery/Teleportation-dithered.png
