emilyahmad/supercon-26/assets/gallery/Thermite-dithered-sierra3.png

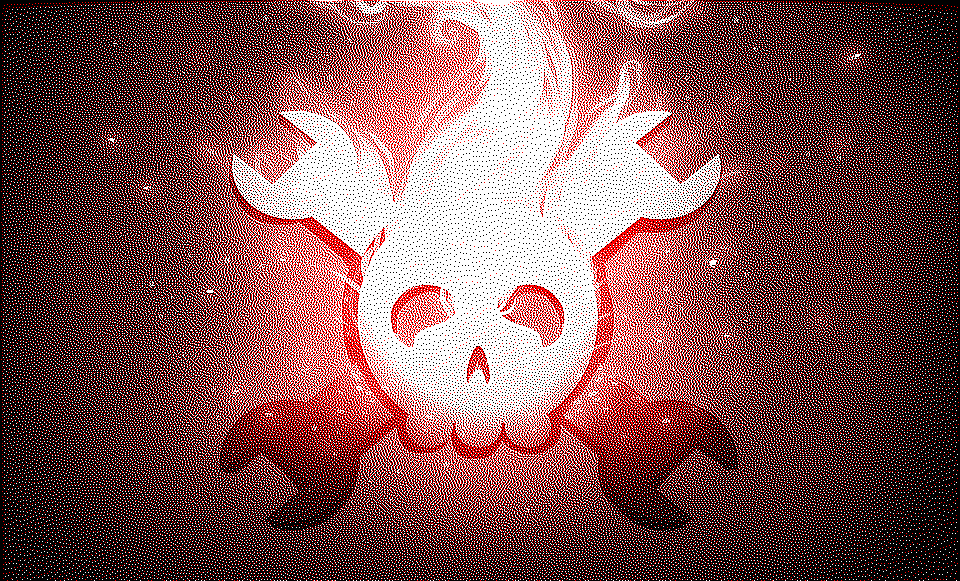
assets/gallery/Thermite-dithered-sierra3.png
