emilyahmad/supercon-26/assets/gallery/VirtualBoy-dithered-atkinson.png

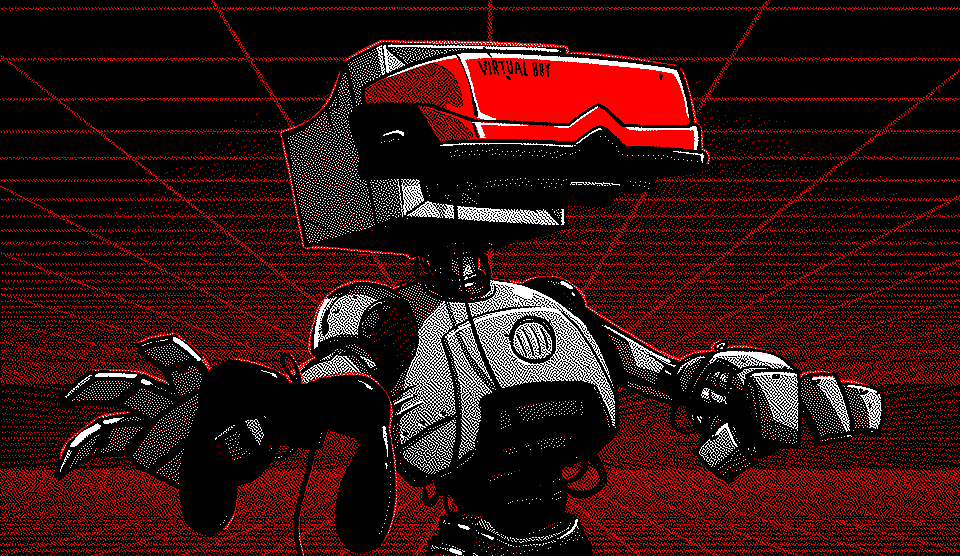
assets/gallery/VirtualBoy-dithered-atkinson.png
