emilyahmad/supercon-26/assets/gallery/Xbox-dithered.png

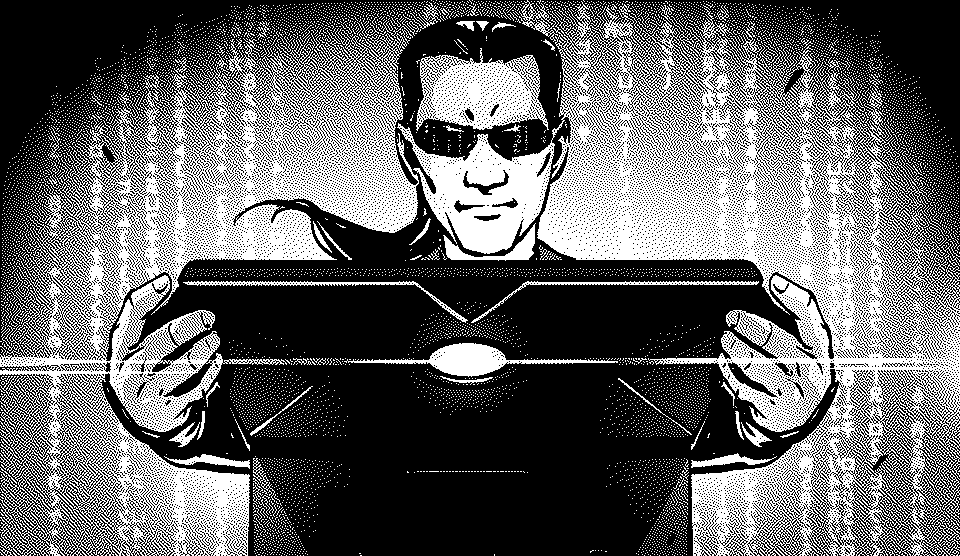
assets/gallery/Xbox-dithered.png
