emilyahmad/supercon-26/assets/graphics/hello_i_am_blank.png

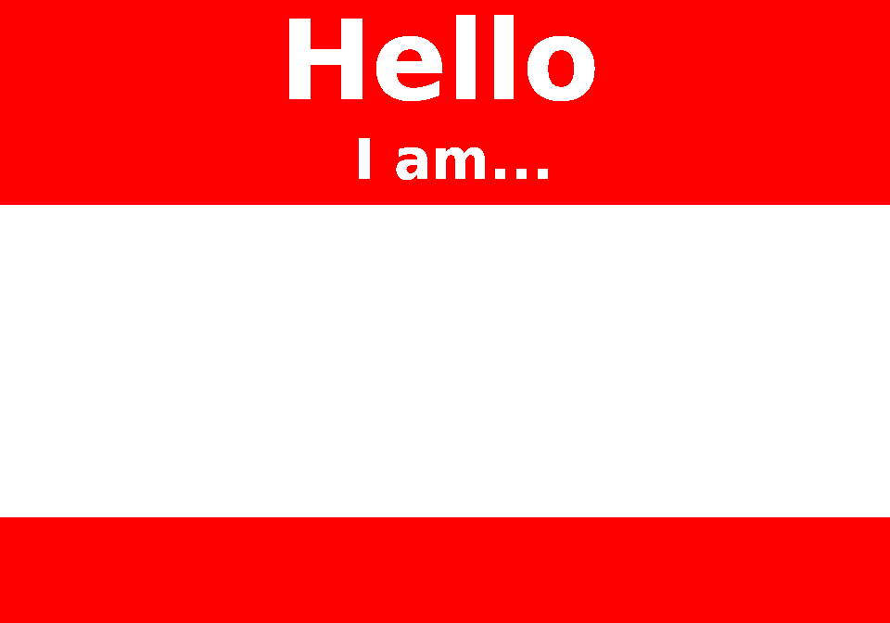
assets/graphics/hello_i_am_blank.png
