emilyahmad/supercon-26/assets/graphics/hello_i_am_hackaday.png

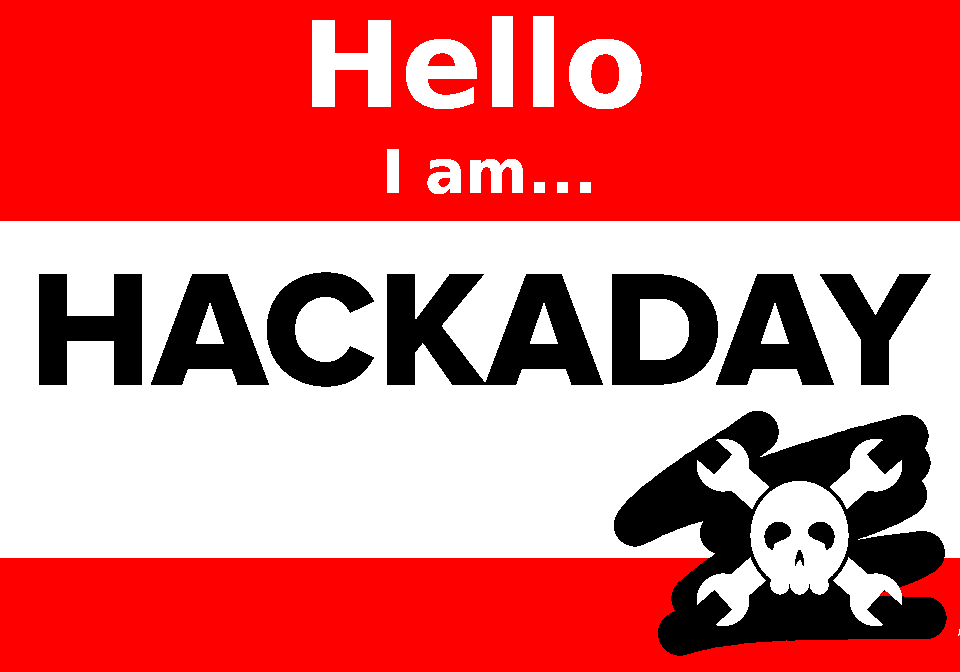
assets/graphics/hello_i_am_hackaday.png
