emilyahmad/supercon-26/assets/graphics/never_epd.png

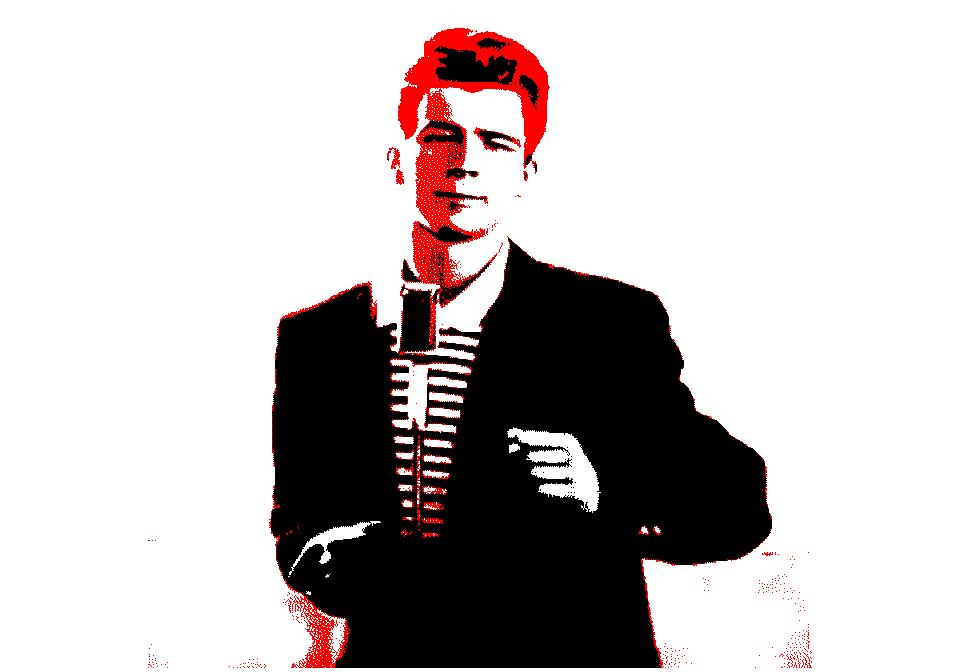
assets/graphics/never_epd.png
