emilyahmad/supercon-26/assets/graphics/SayItWithMe_blank.png

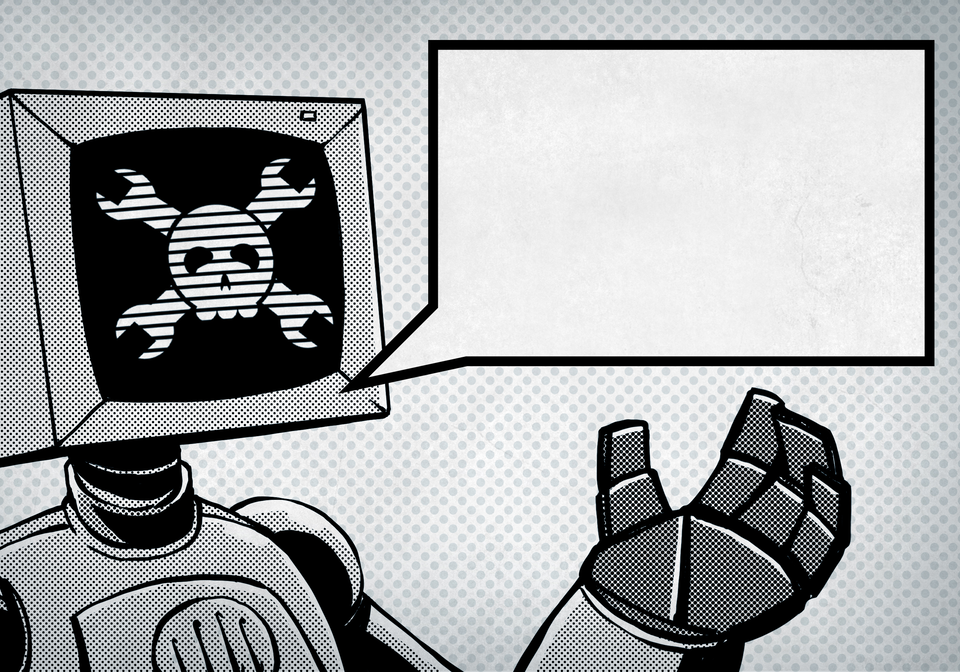
assets/graphics/SayItWithMe_blank.png
