emilyahmad/supercon-26/assets/supercon-x-initial.png

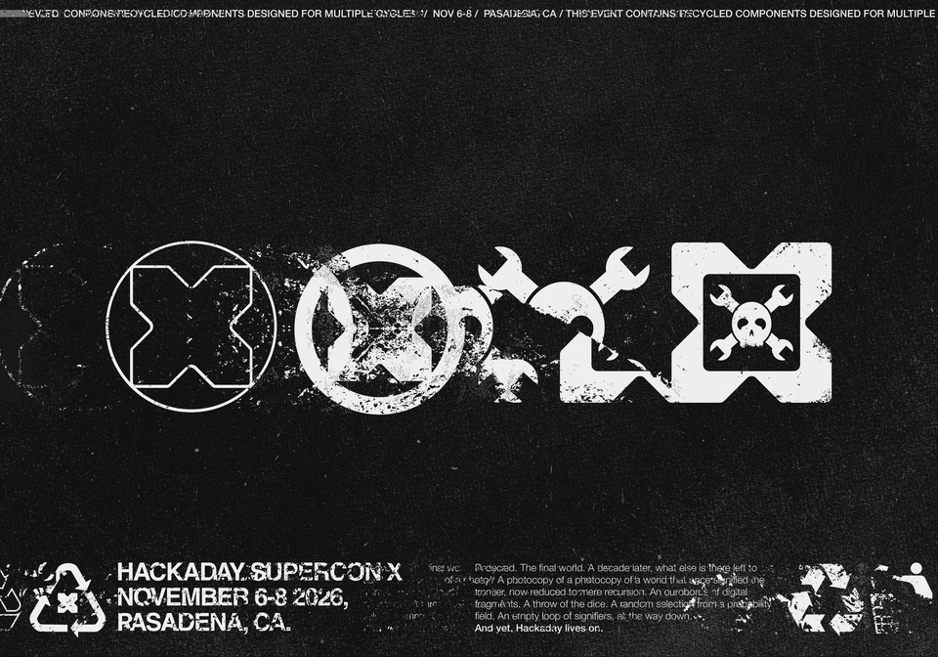
assets/supercon-x-initial.png
