emilyahmad/supercon-26/hardware/billboard_pcb/silkscreen_render.jpg

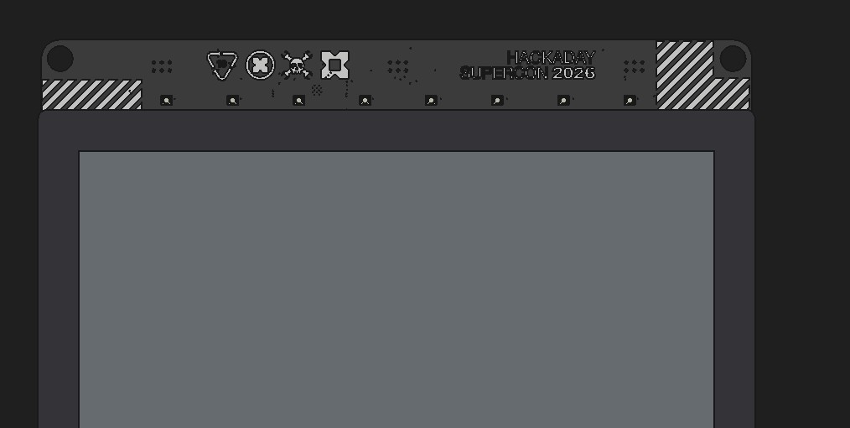
hardware/billboard_pcb/silkscreen_render.jpg
