emilyahmad/supercon-26/hardware/billboard_pcb/billboard_pcb_BOM.csv

Reference | Qty | Value | Footprint | Datasheet | Manufacturer Part | Supplier | Supplier Part | Manufacturer | Description
C1 | 1 | 1u | Capacitor_SMD:C_0603_1608Metric |  |  | LCSC | C1592 |  | Unpolarized capacitor, small symbol
C2,C3,C5,C7,C8,C9,C10 | 7 | 1uF | Capacitor_SMD:C_0603_1608Metric |  | CL10A105KO8NNNC | LCSC | C1592 | SAMSUNG
C4,C6 | 2 | 4.7uF | Capacitor_SMD:C_0603_1608Metric |  | CL10A475KO8NNNC | LCSC | C19666 | SAMSUNG
C11 | 1 | 100nF | Capacitor_SMD:C_0603_1608Metric |  | TCC0603X7R104K500CT | LCSC | C282519 | CCTC
C12,C13,C15 | 3 | 10uF | Capacitor_SMD:C_0603_1608Metric |  |  |  |  |  | Unpolarized capacitor, small symbol
C14 | 1 | 100 nF | Capacitor_SMD:C_0603_1608Metric |  |  |  |  |  | Unpolarized capacitor
D1,D2,D3,D5 | 4 | 1N5819W | easyeda2kicad_fp:SOD-123_L2.7-W1.6-LS3.7-RD |  | 1N5819W | LCSC | C169540 | Shandong Jingdao Microelectronics
D4, D6 | 2 | LED | LED_SMD:LED_0603_1608Metric |  |  | LCSC | C2290 |  | Light emitting diode, 0603, yellow
EPD_ITC1,EPD_ITC2 | 2 | FH34SRJ-24S-0.5SH(50) | easyeda2kicad_fp:FFC-SMD_24P-P0.50_FH34SRJ-24S-0.5SH |  | FH34SRJ-24S-0.5SH(50) | LCSC | C2919499 | Hirose
J1 | 1 | ZX-PH2.0-WT2P | easyeda2kicad_fp:CONN-SMD_ZX-PH2.0-WT2P | https://www.lcsc.com/datasheet/C7429689.pdf |  | LCSC | C7429689 | Megastar(兆星)
J8,J9,J10 | 3 | Simple_Addon_v2 | Simple_Addon_v2:Simple_Addon_v2-BADGE-2x3 | https://hackaday.io/project/175182-simple-add-ons-sao |  | LCSC | C2897404
L1 | 1 | FHW1812IF470JST | easyeda2kicad_fp:IND-SMD_L4.8-W3.4 | https://lcsc.com/product-detail/HF-Inductors_Guangdong-Fenghua-Advanced-Tech-FHW1812IF470JST_C394129.html |  | LCSC | C394129 | FH(风华)
LED1,LED2,LED3,LED4,LED5,LED6,LED7,LED8 | 8 | XL-2121RGBC-WS2812B | easyeda2kicad_fp:LED-SMD_4P-L2.1-W2.1-BR_XL-2121RGBC-WS2812B | https://www.lcsc.com/datasheet/C5349957.pdf |  | LCSC | C5349957 | XINGLIGHT(成兴光)
Q1 | 1 | SI1308EDL-T1-GE3 | easyeda2kicad_fp:SOT-323_L2.0-W1.3-P1.30-LS2.1-BR |  | SI1308EDL-T1-GE3 | LCSC | C469327 | VISHAY(威世)
Q2 | 1 | SK2301AA | easyeda2kicad_fp:SOT-23-3_L2.9-W1.6-P1.90-LS2.8-BR |  | SK2301AA1SHB | LCSC | C118153 | SHIKUES(时科)
Q3 | 1 | DMG2305 | easyeda2kicad_fp:SOT-23-3_L2.9-W1.3-P0.95-LS2.4-BR-1 | https://www.diodes.com/assets/Datasheets/DMG2301L.pdf |  | LCSC | C5261054 |  | -3A Id, -20V Vds, P-Channel MOSFET, SOT-23
R1,R3 | 2 | R_Small | Resistor_SMD:R_0603_1608Metric |  |  |  |  |  | Resistor, small symbol
R2,R7,R12,R13 | 4 | 5.1k | Resistor_SMD:R_0603_1608Metric |  |  |  |  |  | Resistor, small symbol
R4 | 1 | 10K | Resistor_SMD:R_0603_1608Metric |  | RS-03K103JT | LCSC | C73809 | FH
R5 | 1 | 0Ω | Resistor_SMD:R_0603_1608Metric |  |  |  |  |  | Resistor
R6 | 1 | 2k | Resistor_SMD:R_0603_1608Metric |  |  |  |  |  | Resistor, small symbol
R8,R11 | 2 | 100k | Resistor_SMD:R_0603_1608Metric |  |  |  |  |  | Resistor,Resistor, small symbol
R9,R10 | 2 | 10k | Resistor_SMD:R_0603_1608Metric |  |  |  |  |  | Resistor
R14 | 1 | R | Resistor_SMD:R_0603_1608Metric |  |  |  |  |  | Resistor
SW1,SW2 | 2 | SW_SPST | easyeda2kicad_fp:SW-SMD_L3.9-W3.0-P4.45 |  |  | LCSC | C720477 | XUNPU(讯普) | Single Pole Single Throw (SPST) switch
SW3 | 1 | MST22D18G2 125 | easyeda2kicad_fp:SW-SMD_MST22D18G2 | https://www.lcsc.com/datasheet/C2906280.pdf |  | LCSC | C2906280 | SHOU HAN(首韩)
SW4,SW5,SW6,SW7 | 4 | 1TS009B-2500-5000 | easyeda2kicad_fp:SW-SMD_L6.0-W6.0-P6.00-LS6.6 | https://lcsc.com/product-detail/Others_HYP-1TS009B-2500-5000_C255816.html |  | LCSC | C255816 | HYP(鸿源精密)
TP1 | 1 | Battery Pad + | TestPoint:TestPoint_Pad_3.0x3.0mm |  |  |  |  |  | test point
TP2 | 1 | Battery Pad - | TestPoint:TestPoint_Pad_3.0x3.0mm |  |  |  |  |  | test point
TP3 | 1 | TX | TestPoint:TestPoint_Pad_1.5x1.5mm |  |  |  |  |  | test point
TP4 | 1 | RX | TestPoint:TestPoint_Pad_1.5x1.5mm |  |  |  |  |  | test point
TP5 | 1 | GND | TestPoint:TestPoint_Pad_1.5x1.5mm |  |  |  |  |  | test point
TP6 | 1 | GPIO17 | TestPoint:TestPoint_Pad_1.5x1.5mm |  |  |  |  |  | test point
TP7 | 1 | GPIO18 | TestPoint:TestPoint_Pad_1.5x1.5mm |  |  |  |  |  | test point
TP8 | 1 | GPIO9 | TestPoint:TestPoint_Pad_1.5x1.5mm |  |  |  |  |  | test point
TP9 | 1 | GPIO41 | TestPoint:TestPoint_Pad_1.5x1.5mm |  |  |  |  |  | test point
U1 | 1 | ESP32-S3-WROOM-1 | RF_Module:ESP32-S3-WROOM-1 | https://www.espressif.com/sites/default/files/documentation/esp32-s3-wroom-1_wroom-1u_datasheet_en.pdf |  | LCSC | C2913202 |  | RF Module, ESP32-S3 SoC, Wi-Fi 802.11b/g/n, Bluetooth, BLE, 32-bit, 3.3V, onboard antenna, SMD
U2 | 1 | MCP73831-2-OT | Package_TO_SOT_SMD:SOT-23-5 | http://ww1.microchip.com/downloads/en/DeviceDoc/20001984g.pdf |  | LCSC | C424093 |  | Single cell, Li-Ion/Li-Po charge management controller, 4.20V, Tri-State Status Output, in SOT23-5 package
U3 | 1 | AP2112K-3.3 | Package_TO_SOT_SMD:SOT-23-5 | https://www.diodes.com/assets/Datasheets/AP2112.pdf |  | LCSC | C51118 |  | 600mA low dropout linear regulator, with enable pin, 3.8V-6V input voltage range, 3.3V fixed positive output, SOT-23-5
USB1 | 1 | TYPE-C 16PIN 2MD | easyeda2kicad_fp:USB-C-SMD_TYPE-C-16PIN-2MD-073 | https://www.lcsc.com/datasheet/C2765186.pdf |  | LCSC | C2765186 | SHOU HAN(首韩)
