emilyahmad/supercon-26/hardware/billboard_pcb/production/bom.csv

Designator | Footprint | Quantity | Value | LCSC Part #
C1, C10, C2, C3, C5, C7, C8, C9 | 603 | 8 | 1uF | C15849
C11 | 603 | 1 | 100nF
C12, C13, C15 | 603 | 3 | 10uF
C14 | 603 | 1 | 100 nF
C4, C6 | 603 | 2 | 4.7uF
D1, D2, D3, D5 | SOD-123_L2.7-W1.6-LS3.7-RD | 4 | 1N5819W | C963381
D4, D6 | 603 | 2 | LED | C2287
EPD_ITC1, EPD_ITC2 | FFC-SMD_24P-P0.50_FH34SRJ-24S-0.5SH | 2 | FH34SRJ-24S-0.5SH(50) | C324726
J1 | CONN-SMD_ZX-PH2.0-WT2P | 1 | ZX-PH2.0-WT2P | C7429689
J10, J8, J9 | Simple_Addon_v2-BADGE-2x3 | 3 | Simple_Addon_v2 | C2897404
L1 | IND-SMD_L4.8-W3.4 | 1 | FHW1812IF470JST | C394129
LED1, LED2, LED3, LED4, LED5, LED6, LED7, LED8 | LED-SMD_4P-L2.1-W2.1-BR_XL-2121RGBC-WS2812B | 8 | XL-2121RGBC-WS2812B | C5349957
Q1 | SOT-323_L2.0-W1.3-P1.30-LS2.1-BR | 1 | SI1308EDL-T1-GE3 | C469327
Q2 | SOT-23-3_L2.9-W1.6-P1.90-LS2.8-BR | 1 | SK2301AA | C118316
Q3 | SOT-23-3_L2.9-W1.3-P0.95-LS2.4-BR-1 | 1 | DMG2305 | C2940629
R1, R3 | 603 | 2 | 5.1k | C23186
R10, R4, R9 | 603 | 3 | 10k | C25804
R11, R8 | 603 | 2 | 100k | C25803
R12, R13, R2, R7 | 603 | 4 | 5.1k | C23186
R14 | 603 | 1 | 2k | C22975
R5 | 603 | 1 | 0Ω | C21189
R6 | 603 | 1 | 2k | C22975
SW1, SW2 | SW-SMD_L3.9-W3.0-P4.45 | 2 | SW_SPST | C720477
SW3 | SW-SMD_MST22D18G2 | 1 | MST22D18G2 125 | C2906280
SW4, SW5, SW6, SW7 | SW-SMD_L6.0-W6.0-P6.00-LS6.6 | 4 | 1TS009B-2500-5000 | C255816
TP1 | TestPoint_Pad_3.0x3.0mm | 1 | Battery Pad +
TP2 | TestPoint_Pad_3.0x3.0mm | 1 | Battery Pad -
TP3 | TestPoint_Pad_1.5x1.5mm | 1 | TX
TP4 | TestPoint_Pad_1.5x1.5mm | 1 | RX
TP5 | TestPoint_Pad_1.5x1.5mm | 1 | GND
TP8 | TestPoint_Pad_1.5x1.5mm | 1 | GPIO9
TP9 | TestPoint_Pad_1.5x1.5mm | 1 | GPIO41
U1 | ESP32-S3-WROOM-1 | 1 | ESP32-S3-WROOM-1
U2 | SOT-23-5_L3.0-W1.7-P0.95-LS2.8-BL | 1 | MCP73831-2-OT | C424093
U3 | SOT-25-5_L2.9-W1.6-P0.95-LS2.8-BL | 1 | AP2112K-3.3 | C51118
USB1 | USB-C-SMD_TYPE-C-16PIN-2MD-073 | 1 | TYPE-C 16PIN 2MD | C2765186
