emilyahmad/supercon-26/hardware/billboard_mockup-Frame.step

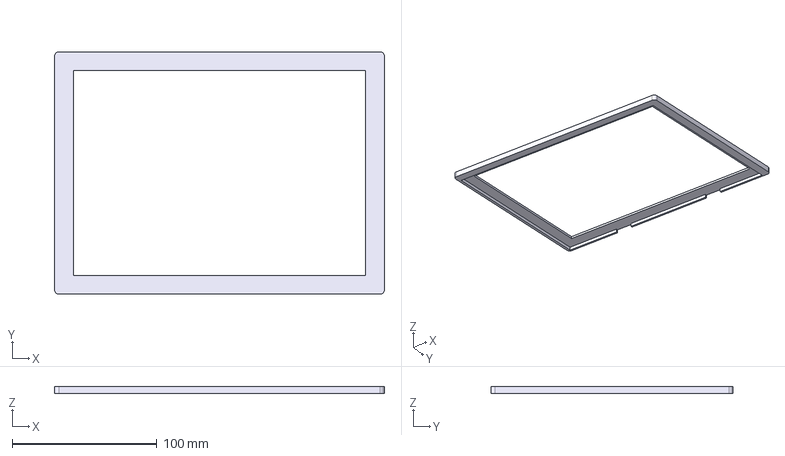
[picture p70: CAD file, 2026-11-07]
hardware/billboard_mockup-Frame.step
227.6 x 167.1 x 5.00 mm
