emilyahmad/supercon-26/hardware/billboard_pcb/billboard_pcb.step

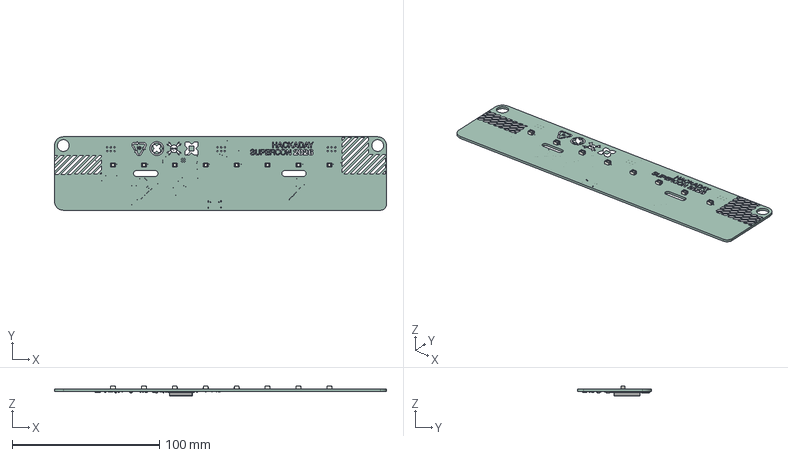
[picture p71: CAD file, 2026-11-07]
hardware/billboard_pcb/billboard_pcb.step
225.6 x 50.0 x 6.83 mm
LED_RGB_Wuerth-PLCC4_3.2x2.8mm_150141M173100 x 8
C_0603_1608Metric x 15
LED_0603_1608Metric x 2
R_0603_1608Metric x 14
SOT-23-3_L2.9-W1.3-P0.95-LS2.4-BR-1
SOT-323_L2.0-W1.3-H1.0-LS2.1-P1.30
SOT-23-3L_L2.9-W1.6-H1.1-LS2.8-P0.95
ESP32-S3-WROOM-1
billboard_pcb_silkscreen x 2
billboard_pcb_PCB
