emilyahmad/supercon-26/hardware/billboard.FCStd

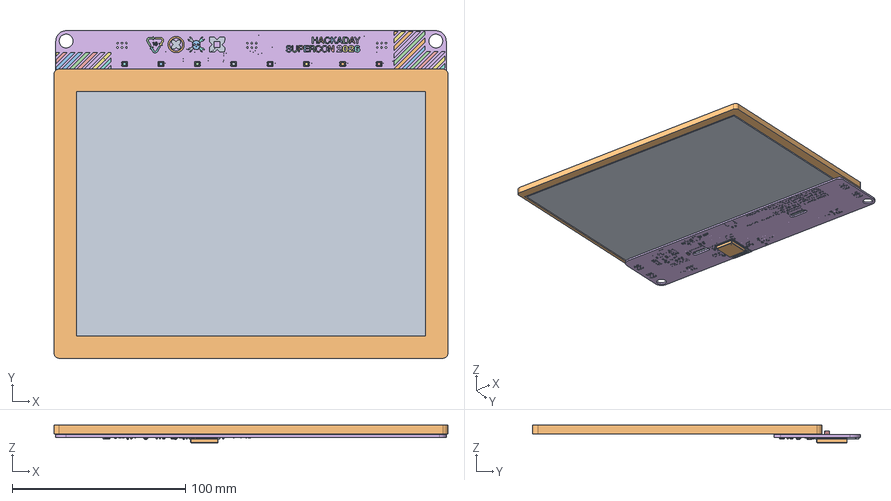
[picture p72: CAD file, 2026-11-07]
hardware/billboard.FCStd
227.6 x 189.3 x 10.2 mm
Screen
Frame
LED_RGB_Wuerth-PLCC4_3.2x2.8mm_150141M173100
LED_RGB_Wuerth-PLCC4_3.2x2.8mm_150141M173102
LED_RGB_Wuerth-PLCC4_3.2x2.8mm_150141M173104
LED_RGB_Wuerth-PLCC4_3.2x2.8mm_150141M173106
LED_RGB_Wuerth-PLCC4_3.2x2.8mm_150141M173108
LED_RGB_Wuerth-PLCC4_3.2x2.8mm_150141M173110
LED_RGB_Wuerth-PLCC4_3.2x2.8mm_150141M173112
LED_RGB_Wuerth-PLCC4_3.2x2.8mm_150141M173114
C_0603_1608Metric
LED_0603_1608Metric
R_0603_1608Metric
R_0603_1608Metric002
C_0603_1608Metric002
C_0603_1608Metric004
C_0603_1608Metric006
SOT-23-3_L2.9-W1.3-P0.95-LS2.4-BR-1
SOT-23-3_L2.9-W1.3-P0.95-LS2.4-BR-001
SOT-23-3_L2.9-W1.3-P0.95-LS2.4-BR-002
SOT-23-3_L2.9-W1.3-P0.95-LS2.4-BR-003
SOT-23-3_L2.9-W1.3-P0.95-LS2.4-BR-004
SOT-23-3_L2.9-W1.3-P0.95-LS2.4-BR-005
SOT-23-3_L2.9-W1.3-P0.95-LS2.4-BR-006
SOT-23-3_L2.9-W1.3-P0.95-LS2.4-BR-007
SOT-23-3_L2.9-W1.3-P0.95-LS2.4-BR-008
SOT-23-3_L2.9-W1.3-P0.95-LS2.4-BR-009
SOT-23-3_L2.9-W1.3-P0.95-LS2.4-BR-010
SOT-23-3_L2.9-W1.3-P0.95-LS2.4-BR-011
SOT-23-3_L2.9-W1.3-P0.95-LS2.4-BR-012
SOT-23-3_L2.9-W1.3-P0.95-LS2.4-BR-013
R_0603_1608Metric004
C_0603_1608Metric008
C_0603_1608Metric010
C_0603_1608Metric012
LED_0603_1608Metric002
C_0603_1608Metric014
C_0603_1608Metric016
R_0603_1608Metric006
R_0603_1608Metric008
R_0603_1608Metric010
C_0603_1608Metric018
C_0603_1608Metric020
R_0603_1608Metric012
R_0603_1608Metric014
SOT-323_L2.0-W1.3-H1.0-LS2.1-P1.30
SOT-323_L2.0-W1.3-H1.0-LS2.1-P1.001
SOT-323_L2.0-W1.3-H1.0-LS2.1-P1.002
SOT-323_L2.0-W1.3-H1.0-LS2.1-P1.003
SOT-323_L2.0-W1.3-H1.0-LS2.1-P1.004
SOT-323_L2.0-W1.3-H1.0-LS2.1-P1.005
SOT-323_L2.0-W1.3-H1.0-LS2.1-P1.006
SOT-323_L2.0-W1.3-H1.0-LS2.1-P1.007
SOT-323_L2.0-W1.3-H1.0-LS2.1-P1.008
SOT-323_L2.0-W1.3-H1.0-LS2.1-P1.009
SOT-323_L2.0-W1.3-H1.0-LS2.1-P1.010
SOT-323_L2.0-W1.3-H1.0-LS2.1-P1.011
SOT-323_L2.0-W1.3-H1.0-LS2.1-P1.012
SOT-323_L2.0-W1.3-H1.0-LS2.1-P1.013
R_0603_1608Metric016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
