emilyahmad/supercon-26/hardware/billboard_pcb/billboard_pcb_mockup.FCStd

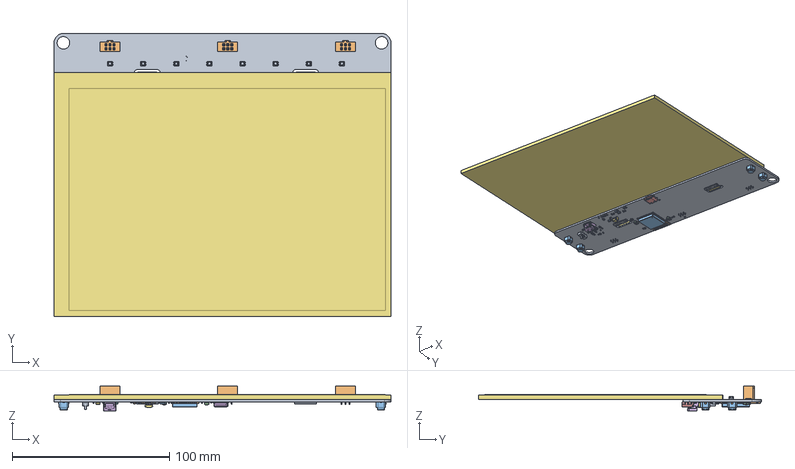
[picture p73: CAD file, 2026-11-07]
hardware/billboard_pcb/billboard_pcb_mockup.FCStd
214.6 x 180.3 x 15.6 mm
Pcb_b349
SFH11-xC-Dx-ST-BK body_03 x 3
pin^SFH11-xC-Dx-ST-BK Ass x 3
pin^SFH11-xC-Dx-ST-BK Ass001 x 3
pin^SFH11-xC-Dx-ST-BK Ass002 x 3
pin^SFH11-xC-Dx-ST-BK Ass003 x 3
pin^SFH11-xC-Dx-ST-BK Ass004 x 3
pin^SFH11-xC-Dx-ST-BK Ass005 x 3
LED2_LED_RGB_Wuerth-PLCC4_3.2x2.8mm_150141M173100_7cade9630063 x 8
C1_C_0603_1608Metric_d381ff969fdb x 15
D2_SOD-123_L2.7-W1.6-LS3.7-RD-2_1962625099e1 x 4
D6_LED_0603_1608Metric_f7ad5e792e28
IND-SMD_L4.8-W3.4
IND-SMD_L4.8-W3.001
IND-SMD_L4.8-W3.002
R10_R_0603_1608Metric_8829a13c6c11 x 14
EPD_ITC1_FFC-SMD_24P-P0.50_FH34SRJ-24S-0.5SH_3847b82d03c8 x 2
SW-SMD_L6.0-W6.0-H5.0-P6.00-LS6.6 x 4
SW-SMD_L6.0-W6.0-H5.0-P6.00-LS6.001 x 4
SW-SMD_L6.0-W6.0-H5.0-P6.00-LS6.002 x 4
SW-SMD_L6.0-W6.0-H5.0-P6.00-LS6.003 x 4
SW-SMD_L6.0-W6.0-H5.0-P6.00-LS6.004 x 4
SW-SMD_L6.0-W6.0-H5.0-P6.00-LS6.005 x 4
SW-SMD_L6.0-W6.0-H5.0-P6.00-LS6.006 x 4
SW-SMD_L6.0-W6.0-H5.0-P6.00-LS6.007 x 4
SW-SMD_L6.0-W6.0-H5.0-P6.00-LS6.008 x 4
SW-SMD_L6.0-W6.0-H5.0-P6.00-LS6.009 x 4
SW-SMD_L6.0-W6.0-H5.0-P6.00-LS6.010 x 4
SW-SMD_L6.0-W6.0-H5.0-P6.00-LS6.011 x 4
SW-SMD_L6.0-W6.0-H5.0-P6.00-LS6.012 x 4
SW-SMD_L6.0-W6.0-H5.0-P6.00-LS6.013 x 4
SW-SMD_L6.0-W6.0-H5.0-P6.00-LS6.014 x 4
SOT-23-3_L2.9-W1.3-P0.95-LS2.4-BR-1
SOT-23-3_L2.9-W1.3-P0.95-LS2.4-BR-001
SOT-23-3_L2.9-W1.3-P0.95-LS2.4-BR-002
SOT-23-3_L2.9-W1.3-P0.95-LS2.4-BR-003
SOT-23-3_L2.9-W1.3-P0.95-LS2.4-BR-004
SOT-23-3_L2.9-W1.3-P0.95-LS2.4-BR-005
SOT-23-3_L2.9-W1.3-P0.95-LS2.4-BR-006
SOT-23-3_L2.9-W1.3-P0.95-LS2.4-BR-007
SOT-23-3_L2.9-W1.3-P0.95-LS2.4-BR-008
SOT-23-3_L2.9-W1.3-P0.95-LS2.4-BR-009
SOT-23-3_L2.9-W1.3-P0.95-LS2.4-BR-010
SOT-23-3_L2.9-W1.3-P0.95-LS2.4-BR-011
SOT-23-3_L2.9-W1.3-P0.95-LS2.4-BR-012
SOT-23-3_L2.9-W1.3-P0.95-LS2.4-BR-013
U2_SOT-23-5_1f0d478000bf x 2
D4_LED_0805_2012Metric_2d4c5ef303a0
SW3_195_22f87f1947d9
SW-SMD_L3.9-W2.9-H2.0-LS4.8 x 2
SW-SMD_L3.9-W2.9-H2.0-LS4.001 x 2
SW-SMD_L3.9-W2.9-H2.0-LS4.002 x 2
SW-SMD_L3.9-W2.9-H2.0-LS4.003 x 2
SW-SMD_L3.9-W2.9-H2.0-LS4.004 x 2
SW-SMD_L3.9-W2.9-H2.0-LS4.005 x 2
SW-SMD_L3.9-W2.9-H2.0-LS4.006 x 2
SW-SMD_L3.9-W2.9-H2.0-LS4.007 x 2
SW-SMD_L3.9-W2.9-H2.0-LS4.008 x 2
SW-SMD_L3.9-W2.9-H2.0-LS4.009 x 2
SW-SMD_L3.9-W2.9-H2.0-LS4.010 x 2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
