emilyahmad/supercon-26/hardware/billboard_mockup.FCStd

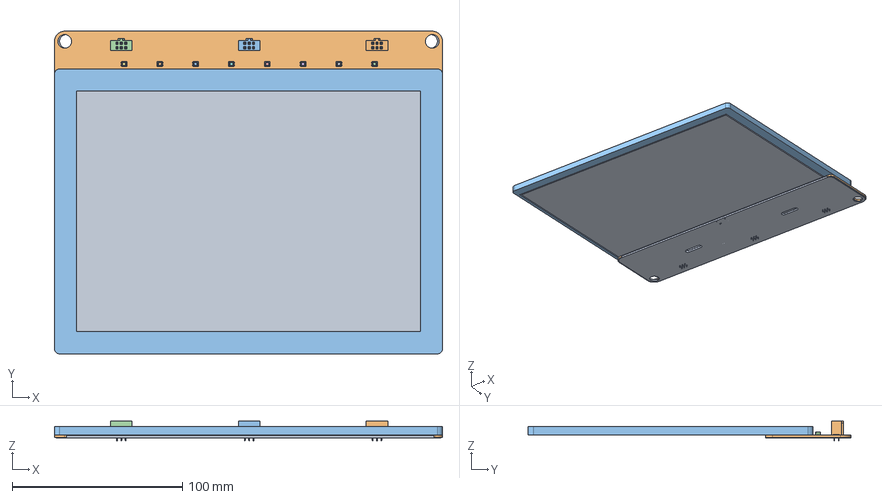
[picture p74: CAD file, 2026-11-07]
hardware/billboard_mockup.FCStd
227.6 x 189.3 x 11.7 mm
Screen
PCB
Frame
SFH11-xC-Dx-ST-BK body_03
pin^SFH11-xC-Dx-ST-BK Ass
pin^SFH11-xC-Dx-ST-BK Ass001
pin^SFH11-xC-Dx-ST-BK Ass002
pin^SFH11-xC-Dx-ST-BK Ass003
pin^SFH11-xC-Dx-ST-BK Ass004
pin^SFH11-xC-Dx-ST-BK Ass005
SFH11-xC-Dx-ST-BK body_001
pin^SFH11-xC-Dx-ST-BK Ass006
pin^SFH11-xC-Dx-ST-BK Ass007
pin^SFH11-xC-Dx-ST-BK Ass008
pin^SFH11-xC-Dx-ST-BK Ass009
pin^SFH11-xC-Dx-ST-BK Ass010
pin^SFH11-xC-Dx-ST-BK Ass011
LED_RGB_Wuerth-PLCC4_3.2x2.8mm_150141M173100
LED_RGB_Wuerth-PLCC4_3.2x2.8mm_150141M173102
LED_RGB_Wuerth-PLCC4_3.2x2.8mm_150141M173104
LED_RGB_Wuerth-PLCC4_3.2x2.8mm_150141M173106
LED_RGB_Wuerth-PLCC4_3.2x2.8mm_150141M173108
LED_RGB_Wuerth-PLCC4_3.2x2.8mm_150141M173110
LED_RGB_Wuerth-PLCC4_3.2x2.8mm_150141M173112
LED_RGB_Wuerth-PLCC4_3.2x2.8mm_150141M173114
SFH11-xC-Dx-ST-BK body_002
pin^SFH11-xC-Dx-ST-BK Ass012
pin^SFH11-xC-Dx-ST-BK Ass013
pin^SFH11-xC-Dx-ST-BK Ass014
pin^SFH11-xC-Dx-ST-BK Ass015
pin^SFH11-xC-Dx-ST-BK Ass016
pin^SFH11-xC-Dx-ST-BK Ass017
billboard_pcb-unsaved-export-ryxofe_PCB
