emilyahmad/supercon-26/(list of files, cad)

Other CAD files:
hardware/billboard_pcb/billboard_pcb.FCStd
