emilyahmad/supercon-26/documentation/FlyerE2969JS0B120201013.pdf

# E2969JS0B1

Size | 9.7" | inch

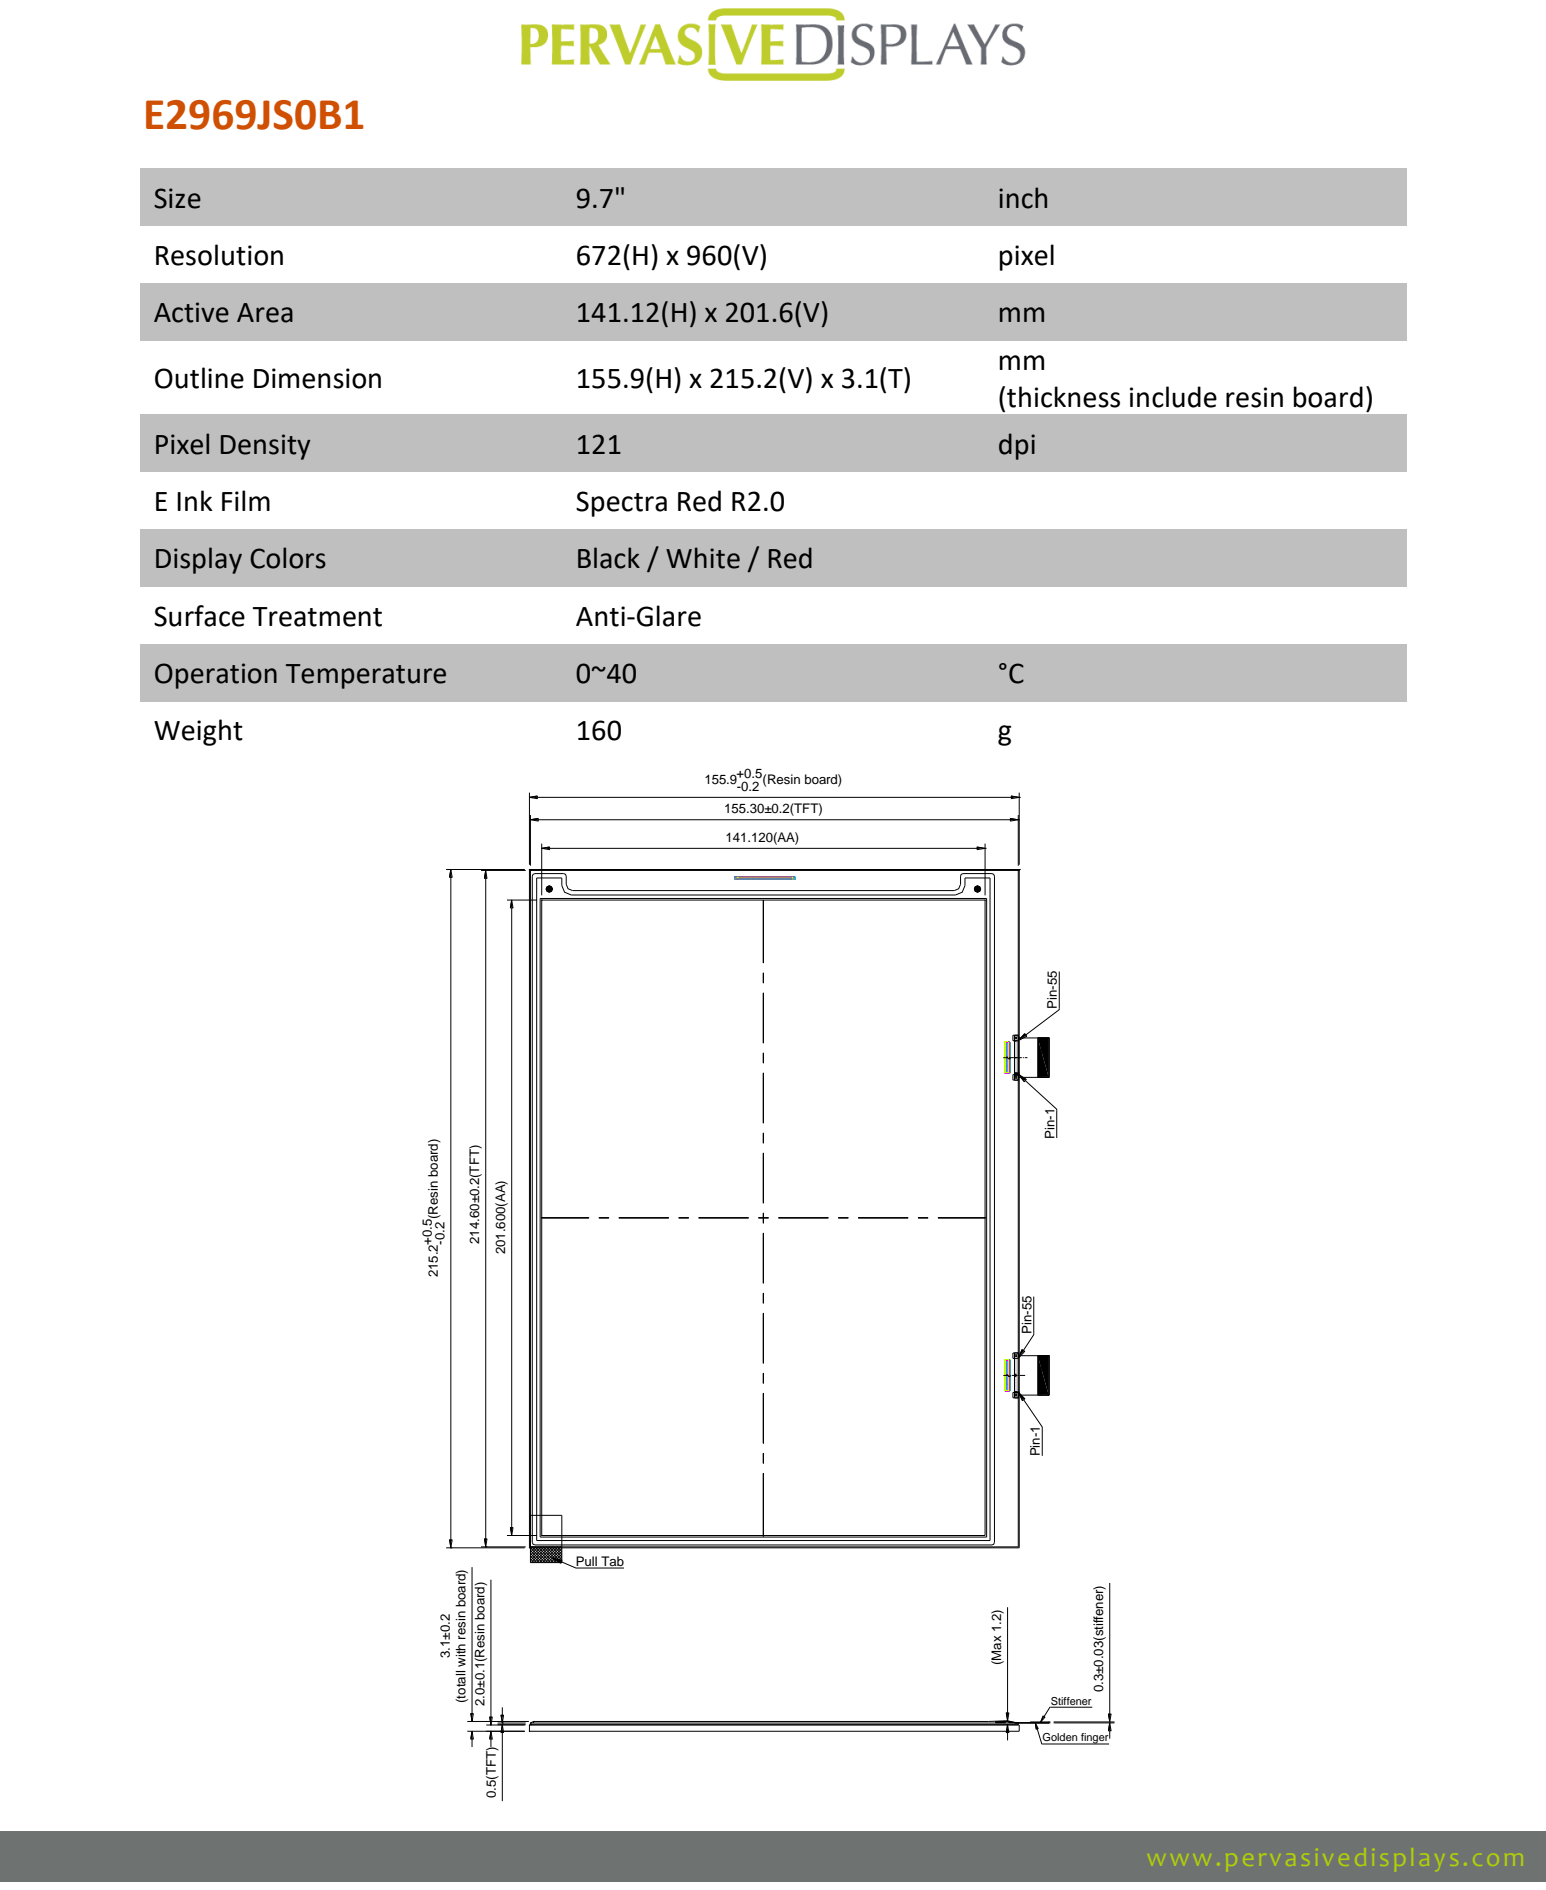
[picture p75: page 1]

(thickness include resin board)

(totall with resin board)
