emilyahmad/supercon-26/hardware/billboard_pcb/billboard_pcb.kicad_pcb

## KiCad design hardware/billboard_pcb/billboard_pcb.kicad_pcb (2026-11-07)

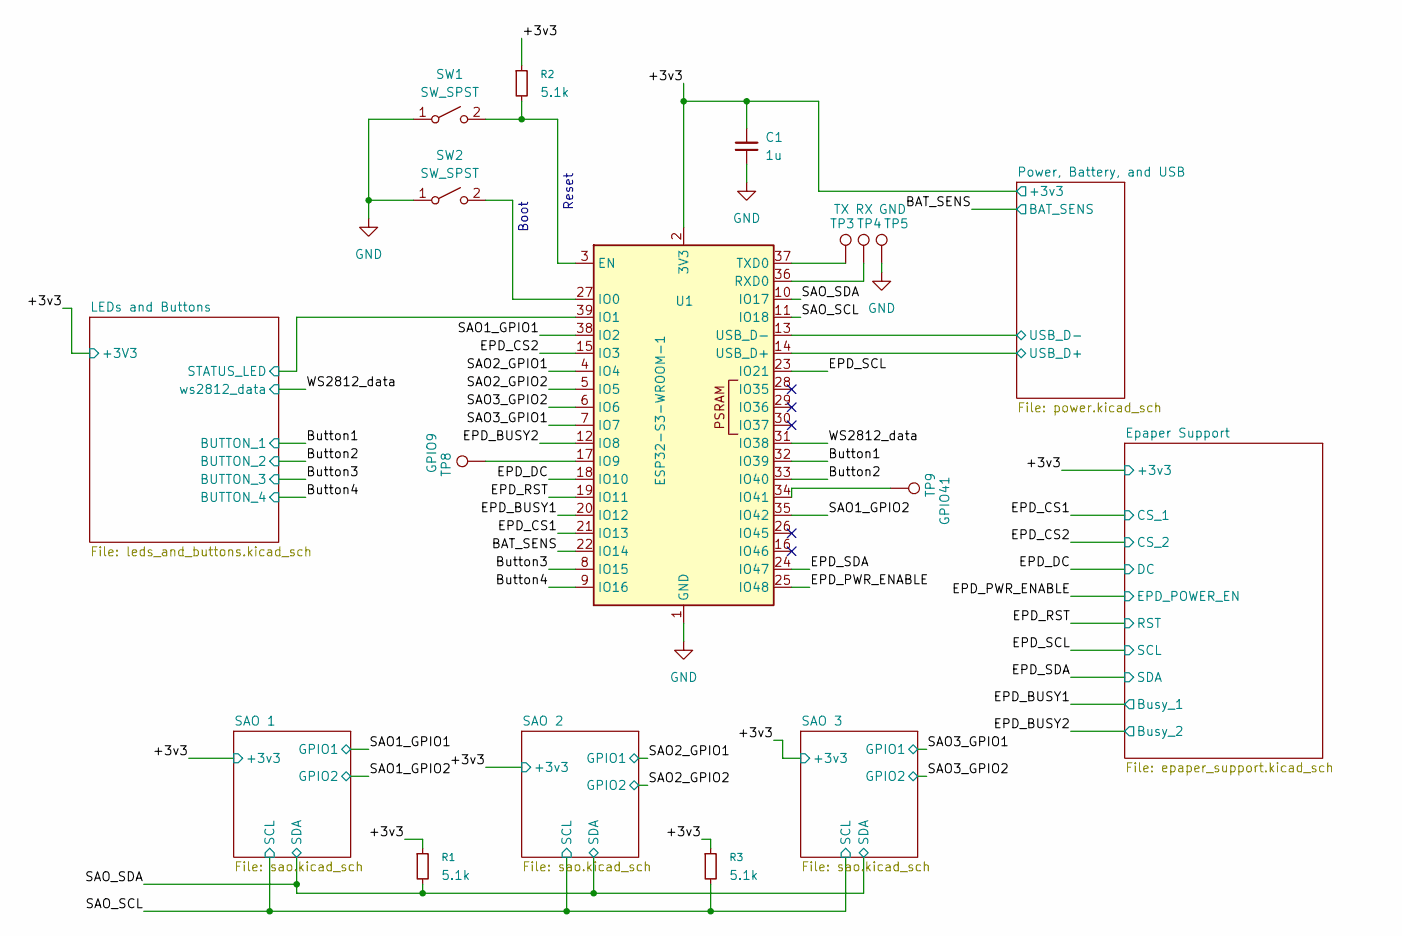
[picture p76: schematic billboard_pcb.kicad_sch, Hackaday Supercon 2026 Billboard Badge]

Parts:
C1: 1u; C_0603_1608Metric
R1, R2, R3: 5.1k; R_0603_1608Metric
SW1, SW2: SW_SPST; SW-SMD_L3.9-W3.0-P4.45
TP3: TX; TestPoint_Pad_1.5x1.5mm
TP4: RX; TestPoint_Pad_1.5x1.5mm
TP5: GND; TestPoint_Pad_1.5x1.5mm
TP8: GPIO9; TestPoint_Pad_1.5x1.5mm
TP9: GPIO41; TestPoint_Pad_1.5x1.5mm
U1: ESP32-S3-WROOM-1

Connections:
/+3v3: C1.1, R1.1, R2.1, R3.1, U1.2 (3V3); also elsewhere on the board
/BAT_SENS: U1.22 (IO14); also elsewhere on the board
/Button1: U1.32 (IO39); also elsewhere on the board
/Button2: U1.33 (IO40); also elsewhere on the board
/Button3: U1.8 (IO15); also elsewhere on the board
/Button4: U1.9 (IO16); also elsewhere on the board
/EPD_BUSY1: U1.20 (IO12); also elsewhere on the board
/EPD_BUSY2: U1.12 (IO8); also elsewhere on the board
/EPD_CS1: U1.21 (IO13); also elsewhere on the board
/EPD_CS2: U1.15 (IO3); also elsewhere on the board
/EPD_DC: U1.18 (IO10); also elsewhere on the board
/EPD_PWR_ENABLE: U1.25 (IO48); also elsewhere on the board
/EPD_RST: U1.19 (IO11); also elsewhere on the board
/EPD_SCL: U1.23 (IO21); also elsewhere on the board
/EPD_SDA: U1.24 (IO47); also elsewhere on the board
/LEDs and Buttons/STATUS_LED: U1.39 (IO1); also elsewhere on the board
/Power, Battery, and USB/USB_D+: U1.14 (USB_D+); also elsewhere on the board
/Power, Battery, and USB/USB_D-: U1.13 (USB_D-); also elsewhere on the board
/SAO1_GPIO1: U1.38 (IO2); also elsewhere on the board
/SAO1_GPIO2: U1.35 (IO42); also elsewhere on the board
/SAO2_GPIO1: U1.4 (IO4); also elsewhere on the board
/SAO2_GPIO2: U1.5 (IO5); also elsewhere on the board
/SAO3_GPIO1: U1.7 (IO7); also elsewhere on the board
/SAO3_GPIO2: U1.6 (IO6); also elsewhere on the board
/SAO_SCL: R3.2, U1.11 (IO18); also elsewhere on the board
/SAO_SDA: R1.2, U1.10 (IO17); also elsewhere on the board
/WS2812_data: U1.31 (IO38); also elsewhere on the board
GND: C1.2, SW1.1 (A), SW2.1 (A), TP5.1 (1_1), U1.1 (GND), U1.40 (GND), U1.41 (GND); also elsewhere on the board
unnamed: R2.2, SW1.2 (B), U1.3 (EN)
unnamed: SW2.2 (B), U1.27 (IO0)
unnamed: TP8.1 (1_1), U1.17 (IO9)
unnamed: TP9.1 (1_1), U1.34 (IO41)
unnamed: TP4.1 (1_1), U1.36 (RXD0)
unnamed: TP3.1 (1_1), U1.37 (TXD0)

Notes on the sheet:
Boot
Reset

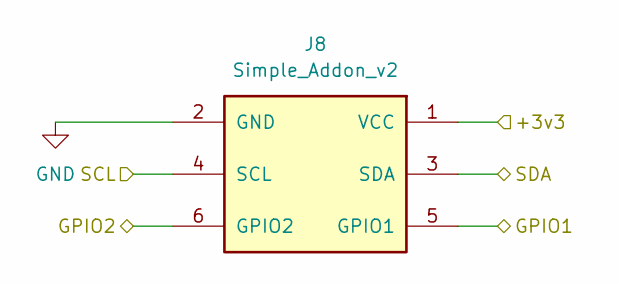
[picture p77: schematic sao.kicad_sch]

Parts:
J8: Simple_Addon_v2; Simple_Addon_v2-BADGE-2x3

Connections:
/+3v3: J8.1 (VCC); also elsewhere on the board
/SAO1_GPIO1: J8.5 (GPIO1); also elsewhere on the board
/SAO1_GPIO2: J8.6 (GPIO2); also elsewhere on the board
/SAO_SCL: J8.4 (SCL); also elsewhere on the board
/SAO_SDA: J8.3 (SDA); also elsewhere on the board
GND: J8.2 (GND); also elsewhere on the board

Parts of its further copies:
J9, J10: Simple_Addon_v2; Simple_Addon_v2-BADGE-2x3

Connections of its further copies:
/+3v3: J9.1 (VCC), J10.1 (VCC); also elsewhere on the board
/SAO2_GPIO1: J9.5 (GPIO1); also elsewhere on the board
/SAO2_GPIO2: J9.6 (GPIO2); also elsewhere on the board
/SAO3_GPIO1: J10.5 (GPIO1); also elsewhere on the board
/SAO3_GPIO2: J10.6 (GPIO2); also elsewhere on the board
/SAO_SCL: J9.4 (SCL), J10.4 (SCL); also elsewhere on the board
/SAO_SDA: J9.3 (SDA), J10.3 (SDA); also elsewhere on the board
GND: J9.2 (GND), J10.2 (GND); also elsewhere on the board

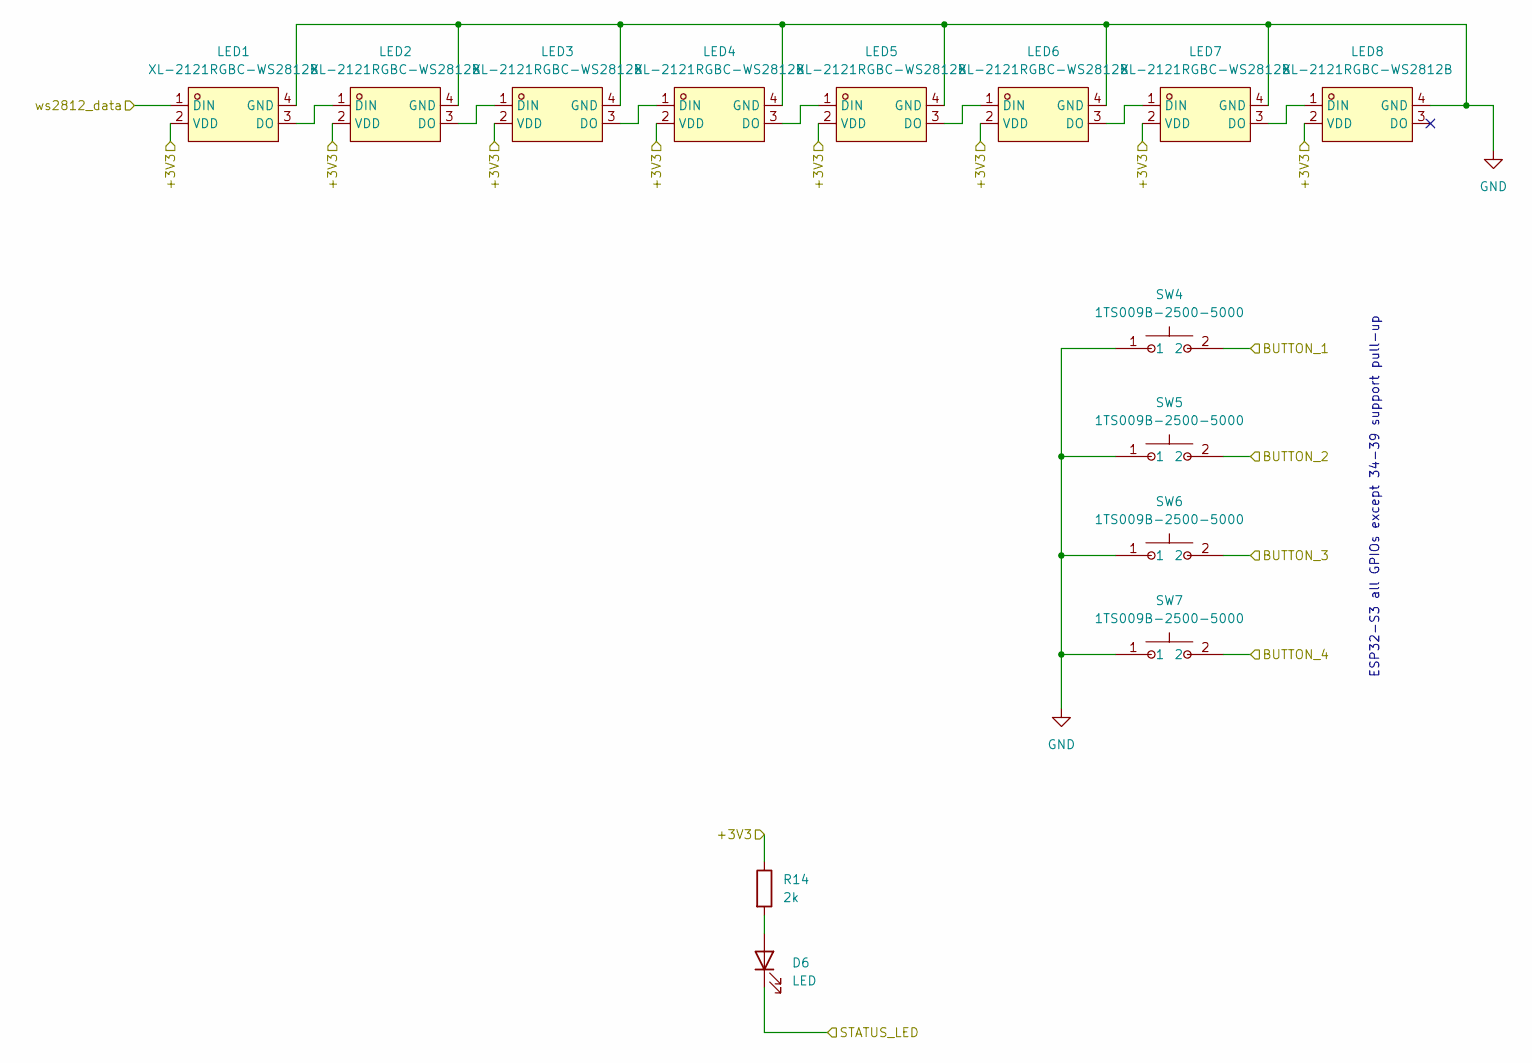
[picture p78: schematic leds_and_buttons.kicad_sch]

Parts:
D6: LED; LED_0603_1608Metric
LED1, LED2, LED3, LED4, LED5, LED6, LED7, LED8: XL-2121RGBC-WS2812B; LED-SMD_4P-L2.1-W2.1-BR_XL-2121RGBC-WS2812B; MPN XL-2121RGBC-2812B; LCSC Part C5349957
R14: 2k; R_0603_1608Metric
SW4, SW5, SW6, SW7: 1TS009B-2500-5000; SW-SMD_L6.0-W6.0-P6.00-LS6.6; MPN 1TS009B-2500-5000-CT; LCSC Part C255816

Connections:
/+3v3: LED1.2 (VDD), LED2.2 (VDD), LED3.2 (VDD), LED4.2 (VDD), LED5.2 (VDD), LED6.2 (VDD), LED7.2 (VDD), LED8.2 (VDD), R14.1; also elsewhere on the board
/Button1: SW4.2; also elsewhere on the board
/Button2: SW5.2; also elsewhere on the board
/Button3: SW6.2; also elsewhere on the board
/Button4: SW7.2; also elsewhere on the board
/LEDs and Buttons/STATUS_LED: D6.1 (K); also elsewhere on the board
/WS2812_data: LED1.1 (DIN); also elsewhere on the board
GND: LED1.4 (GND), LED2.4 (GND), LED3.4 (GND), LED4.4 (GND), LED5.4 (GND), LED6.4 (GND), LED7.4 (GND), LED8.4 (GND), SW4.1, SW5.1, SW6.1, SW7.1; also elsewhere on the board
unnamed: D6.2 (A), R14.2
unnamed: LED1.3 (DO), LED2.1 (DIN)
unnamed: LED2.3 (DO), LED3.1 (DIN)
unnamed: LED3.3 (DO), LED4.1 (DIN)
unnamed: LED4.3 (DO), LED5.1 (DIN)
unnamed: LED5.3 (DO), LED6.1 (DIN)
unnamed: LED6.3 (DO), LED7.1 (DIN)
unnamed: LED7.3 (DO), LED8.1 (DIN)

Notes on the sheet:
ESP32-S3 all GPIOs except 34-39 support pull-up

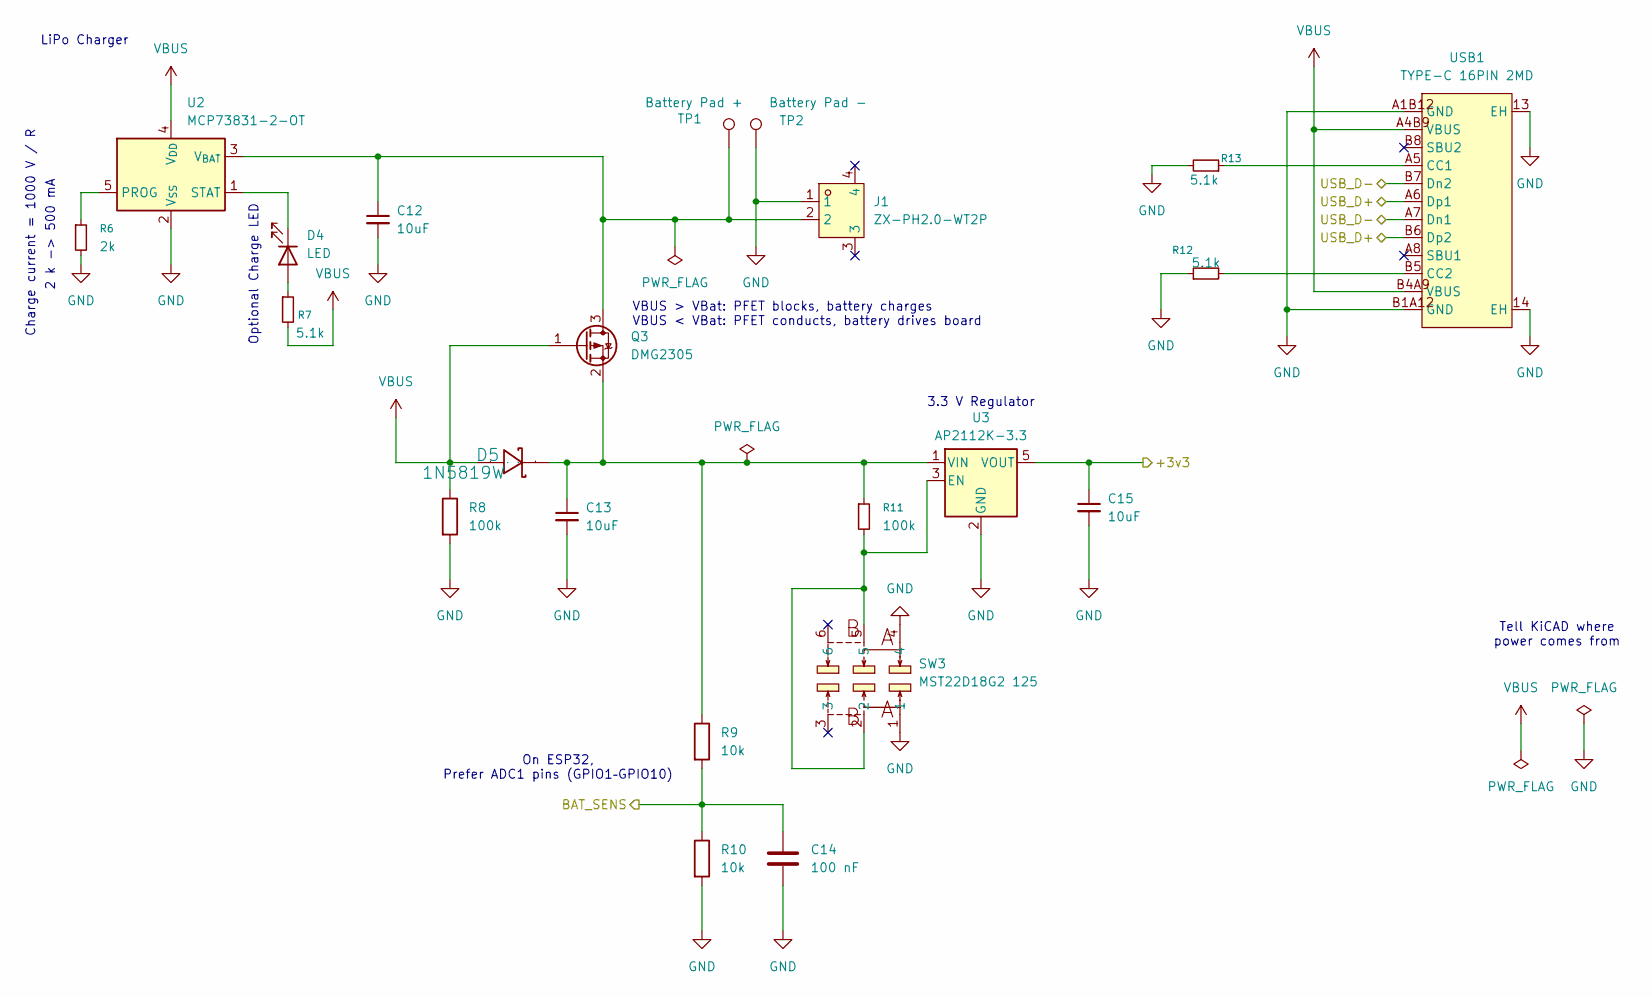
[picture p79: schematic power.kicad_sch]

Parts:
C12, C13, C15: 10uF; C_0603_1608Metric
C14: 100 nF; C_0603_1608Metric
D4: LED; LED_0603_1608Metric
D5: 1N5819W; SOD-123_L2.7-W1.6-LS3.7-RD; Manufacturer Part 1N5819W; LCSC Part C963381
J1: ZX-PH2.0-WT2P; CONN-SMD_ZX-PH2.0-WT2P; MPN ZX-PH2.0-WT2P; LCSC Part C7429689
Q3: DMG2305; SOT-23-3_L2.9-W1.3-P0.95-LS2.4-BR-1; LCSC Part C2940629
R6: 2k; R_0603_1608Metric
R7, R12, R13: 5.1k; R_0603_1608Metric
R8, R11: 100k; R_0603_1608Metric
R9, R10: 10k; R_0603_1608Metric
SW3: MST22D18G2 125; SW-SMD_MST22D18G2; MPN MST22D18G2 125; LCSC Part C2906280
TP1: Battery Pad +; TestPoint_Pad_3.0x3.0mm
TP2: Battery Pad -; TestPoint_Pad_3.0x3.0mm
U2: MCP73831-2-OT; SOT-23-5_L3.0-W1.7-P0.95-LS2.8-BL; LCSC Part C424093
U3: AP2112K-3.3; SOT-25-5_L2.9-W1.6-P0.95-LS2.8-BL; LCSC Part C51118
USB1: TYPE-C 16PIN 2MD; USB-C-SMD_TYPE-C-16PIN-2MD-073; MPN TYPE-C 16PIN 2MD(073); LCSC Part C2765186

Connections:
/+3v3: C15.1, U3.5 (VOUT); also elsewhere on the board
/BAT_SENS: C14.1, R9.2, R10.1; also elsewhere on the board
/Power, Battery, and USB/USB_D+: USB1.A6 (Dp1), USB1.B6 (Dp2); also elsewhere on the board
/Power, Battery, and USB/USB_D-: USB1.A7 (Dn1), USB1.B7 (Dn2); also elsewhere on the board
GND: C12.2, C13.2, C14.2, C15.2, J1.1, R6.2, R8.2, R10.2, R12.1, R13.2, SW3.1, SW3.4, TP2.1 (1_1), U2.2 (V_{SS}), U3.2 (GND), USB1.13 (EH), USB1.14 (EH), USB1.A1B12 (GND), USB1.B1A12 (GND); also elsewhere on the board
unnamed: D4.2 (A), R7.1
unnamed: D4.1 (K), U2.1 (STAT)
unnamed: C12.1, J1.2, Q3.3 (D), TP1.1 (1_1), U2.3 (V_{BAT})
unnamed: C13.1, D5.1, Q3.2 (S), R9.1, R11.1, U3.1 (VIN)
unnamed: R6.1, U2.5 (PROG)
unnamed: R11.2, SW3.2, SW3.5, U3.3 (EN)
unnamed: R13.1, USB1.A5 (CC1)
unnamed: R12.2, USB1.B5 (CC2)
VBUS: D5.2, Q3.1 (G), R7.2, R8.1, U2.4 (V_{DD}), USB1.A4B9 (VBUS), USB1.B4A9 (VBUS)

Notes on the sheet:
3.3 V Regulator
Optional Charge LED
On ESP32, Prefer ADC1 pins (GPIO1–GPIO10)
VBUS > VBat: PFET blocks, battery charges VBUS < VBat: PFET conducts, battery drives board
LiPo Charger
2 k -> 500 mA
Tell KiCAD where power comes from
Charge current = 1000 V / R

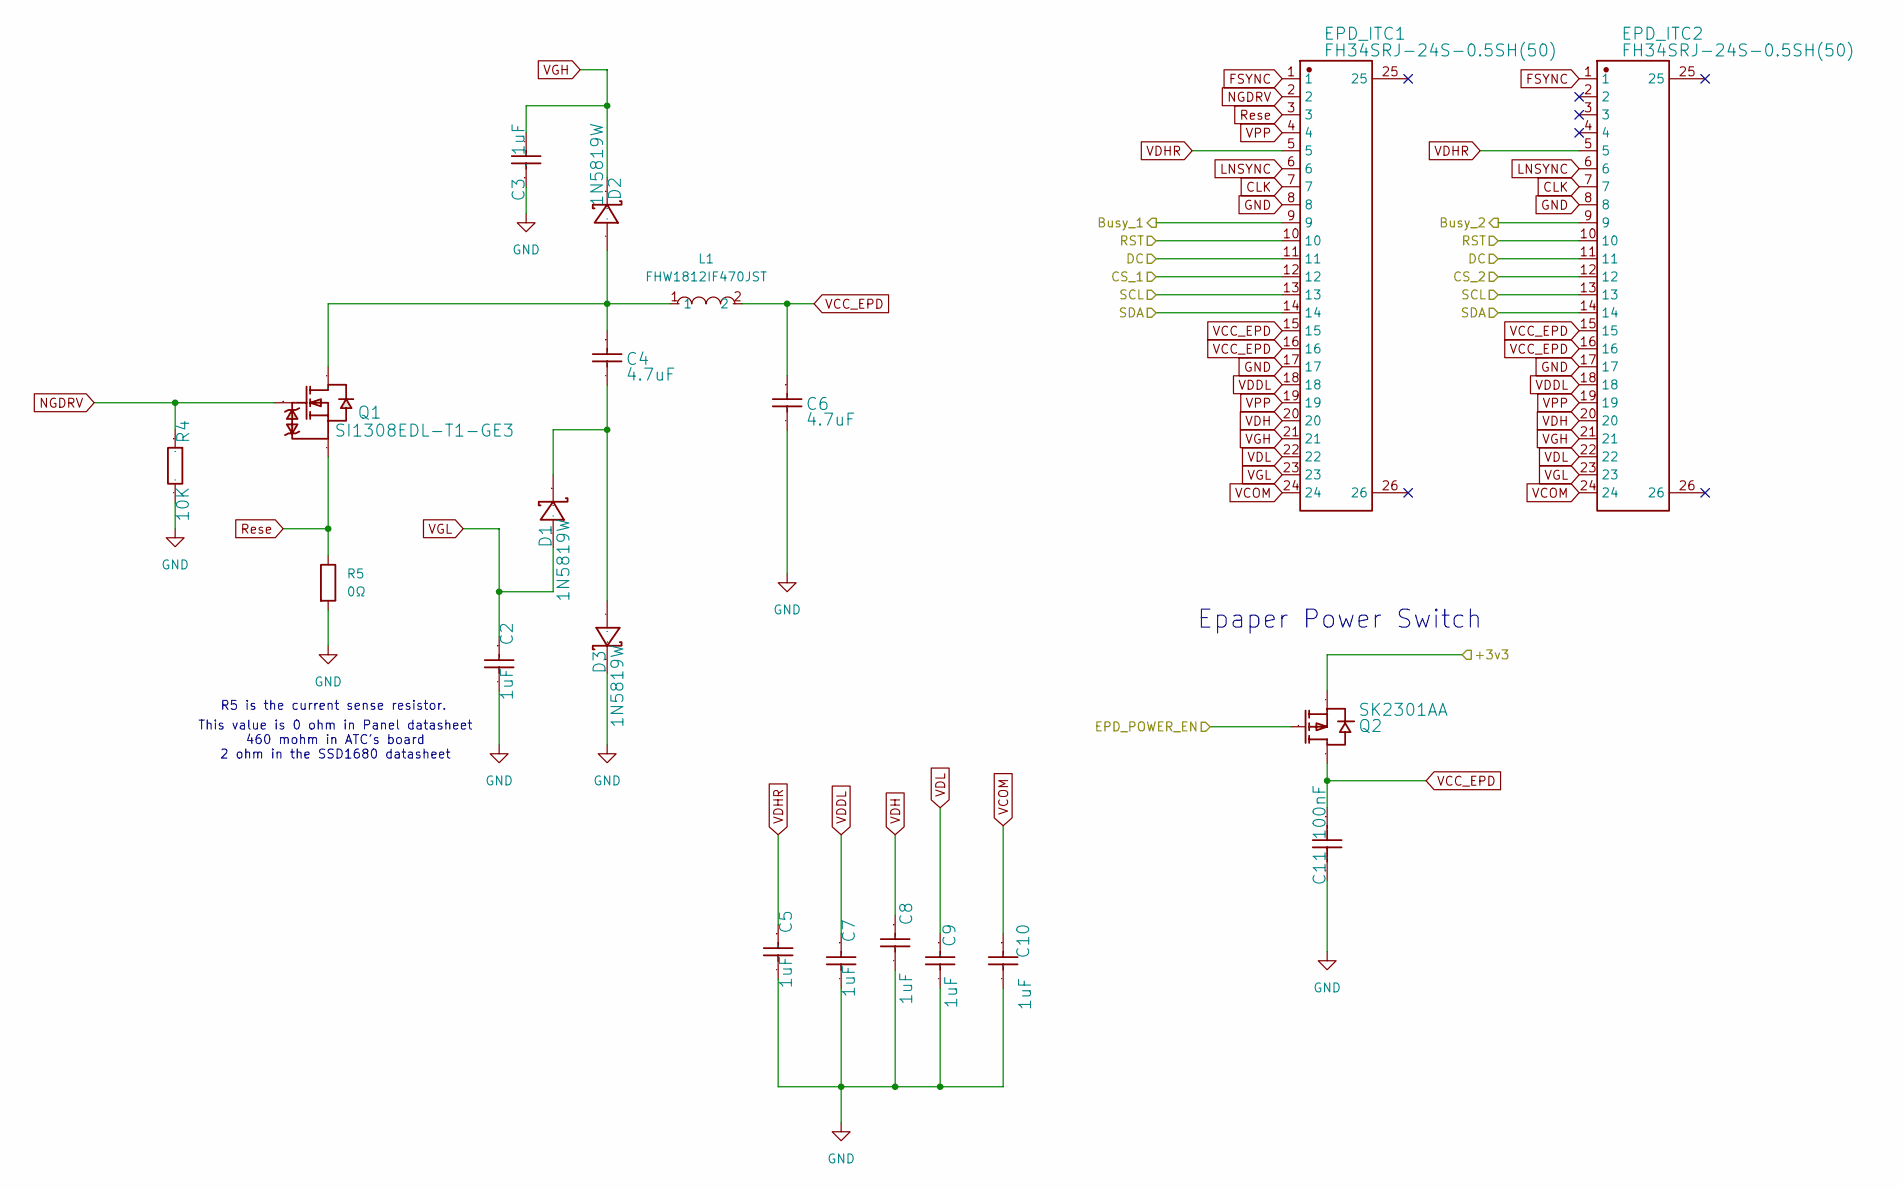
[picture p80: schematic epaper_support.kicad_sch]

Parts:
C2, C3, C5, C7, C8, C9, C10: 1uF; C_0603_1608Metric; Manufacturer Part CL10A105KO8NNNC
C4, C6: 4.7uF; C_0603_1608Metric; Manufacturer Part CL10A475KO8NNNC
C11: 100nF; C_0603_1608Metric; Manufacturer Part TCC0603X7R104K500CT
D1, D2, D3: 1N5819W; SOD-123_L2.7-W1.6-LS3.7-RD; Manufacturer Part 1N5819W; LCSC Part C963381
EPD_ITC1, EPD_ITC2: FH34SRJ-24S-0.5SH(50); FFC-SMD_24P-P0.50_FH34SRJ-24S-0.5SH; Manufacturer Part FH34SRJ-24S-0.5SH(50); LCSC Part C324726
L1: FHW1812IF470JST; IND-SMD_L4.8-W3.4; MPN FHW1812IF470JST; LCSC Part C394129
Q1: SI1308EDL-T1-GE3; SOT-323_L2.0-W1.3-P1.30-LS2.1-BR; Manufacturer Part SI1308EDL-T1-GE3; LCSC Part C469327
Q2: SK2301AA; SOT-23-3_L2.9-W1.6-P1.90-LS2.8-BR; Manufacturer Part SK2301AA1SHB; LCSC Part C118316
R4: 10K; R_0603_1608Metric; Manufacturer Part RS-03K103JT
R5: 0Ω; R_0603_1608Metric

Connections:
/+3v3: Q2.2 (S); also elsewhere on the board
/EPD_BUSY1: EPD_ITC1.9; also elsewhere on the board
/EPD_BUSY2: EPD_ITC2.9; also elsewhere on the board
/EPD_CS1: EPD_ITC1.12; also elsewhere on the board
/EPD_CS2: EPD_ITC2.12; also elsewhere on the board
/EPD_DC: EPD_ITC1.11, EPD_ITC2.11; also elsewhere on the board
/EPD_PWR_ENABLE: Q2.1 (G); also elsewhere on the board
/EPD_RST: EPD_ITC1.10, EPD_ITC2.10; also elsewhere on the board
/EPD_SCL: EPD_ITC1.13, EPD_ITC2.13; also elsewhere on the board
/EPD_SDA: EPD_ITC1.14, EPD_ITC2.14; also elsewhere on the board
CLK: EPD_ITC1.7, EPD_ITC2.7
FSYNC: EPD_ITC1.1, EPD_ITC2.1
GND: C2.2, C3.1, C5.2, C6.2, C7.2, C8.2, C9.2, C10.2, C11.2, D3.1, EPD_ITC1.8, EPD_ITC1.17, EPD_ITC2.8, EPD_ITC2.17, R4.2, R5.2; also elsewhere on the board
LNSYNC: EPD_ITC1.6, EPD_ITC2.6
NGDRV: EPD_ITC1.2, Q1.1 (G), R4.1
unnamed: C4.2, D1.1, D3.2
unnamed: C4.1, D2.2, L1.1, Q1.3 (D)
Rese: EPD_ITC1.3, Q1.2 (S), R5.1
VCC_EPD: C6.1, C11.1, EPD_ITC1.15, EPD_ITC1.16, EPD_ITC2.15, EPD_ITC2.16, L1.2, Q2.3 (D)
VCOM: C10.1, EPD_ITC1.24, EPD_ITC2.24
VDDL: C7.1, EPD_ITC1.18, EPD_ITC2.18
VDH: C8.1, EPD_ITC1.20, EPD_ITC2.20
VDHR: C5.1, EPD_ITC1.5, EPD_ITC2.5
VDL: C9.1, EPD_ITC1.22, EPD_ITC2.22
VGH: C3.2, D2.1, EPD_ITC1.21, EPD_ITC2.21
VGL: C2.1, D1.2, EPD_ITC1.23, EPD_ITC2.23
VPP: EPD_ITC1.4, EPD_ITC1.19, EPD_ITC2.19

Notes on the sheet:
R5 is the current sense resistor.
Epaper Power Switch
This value is 0 ohm in Panel datasheet 460 mohm in ATC's board 2 ohm in the SSD1680 datasheet

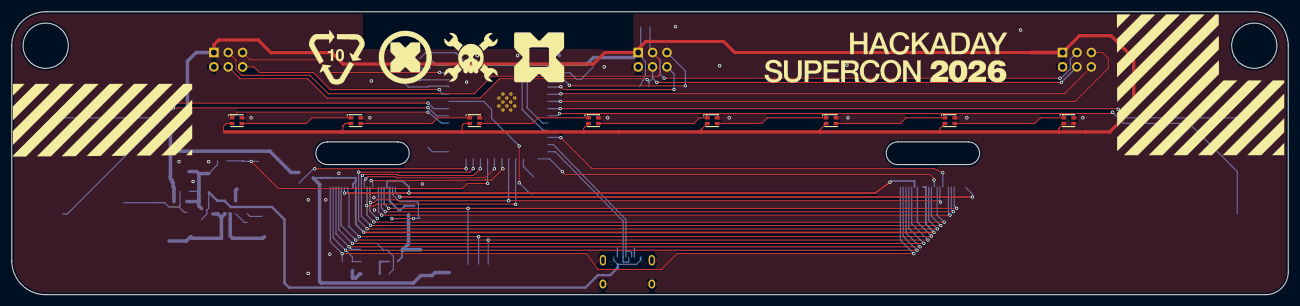
[picture p81: board billboard_pcb.kicad_pcb from above]

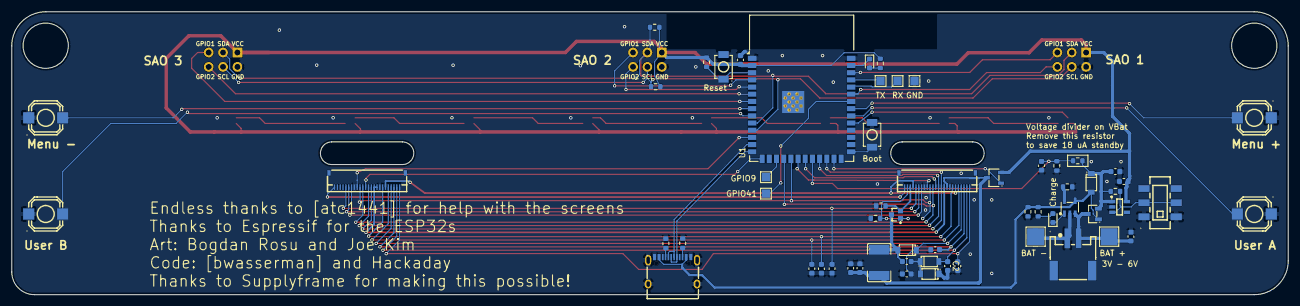
[picture p82: board billboard_pcb.kicad_pcb from below]

Board: 2 copper layers, 225.6 x 50.0 mm, 71 parts (60 on the bottom side), 67 nets.
